Synthron/Nixie/README.md

# Nixie

A Nixie Clock with Z5600M and ESP32
