Synthron/Nixie/Hardware/dots_spacer.FCStd

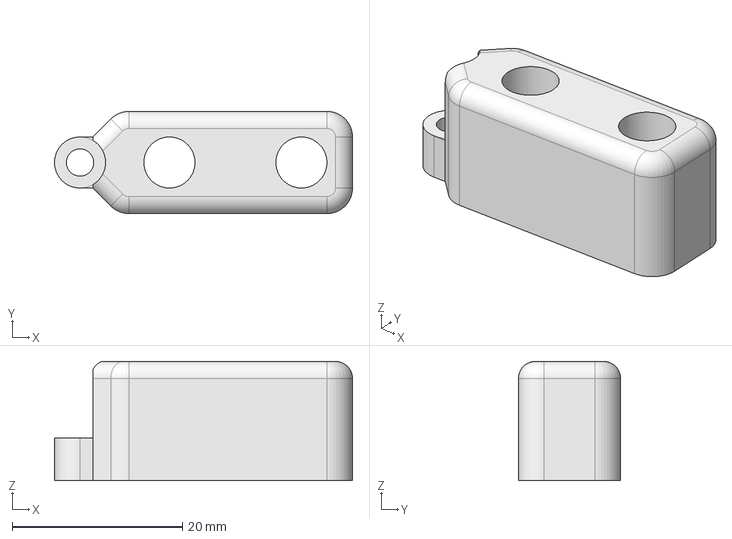
[picture p1: CAD file, 2024-10-21]
Hardware/dots_spacer.FCStd
35.0 x 12.0 x 14.0 mm
