Synthron/Nixie/Hardware/PCB/3d/NE-2 - Neon.STEP

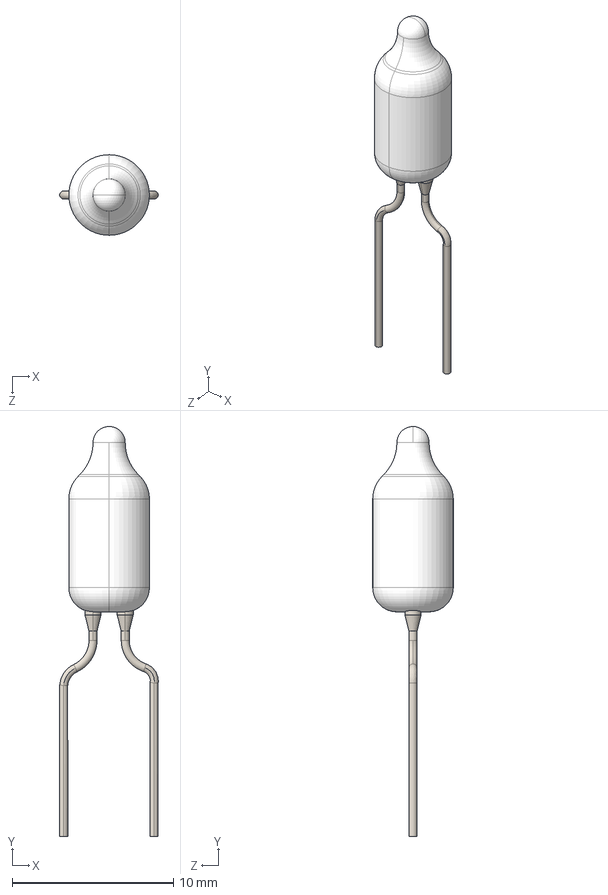
[picture p2: CAD file, 2024-09-22]
Hardware/PCB/3d/NE-2 - Neon.STEP
6.12 x 25.4 x 5.00 mm
