Synthron/Nixie/Hardware/covers.FCStd

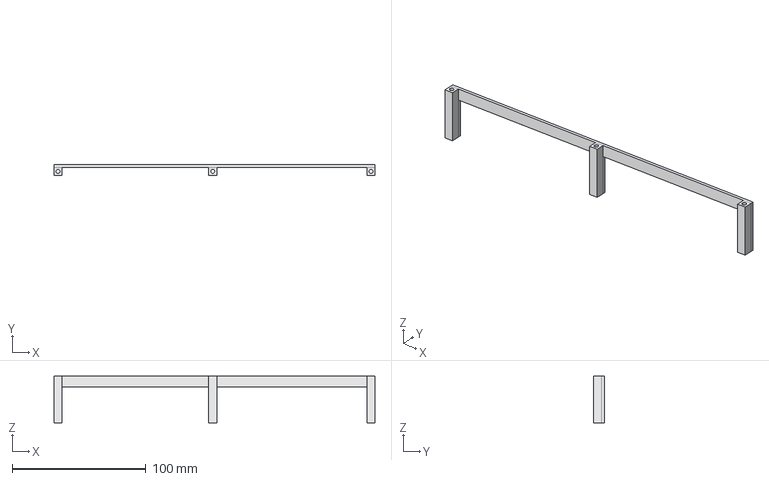
[picture p3: CAD file, 2024-10-21]
Hardware/covers.FCStd
240.0 x 8.00 x 35.0 mm
