Synthron/Nixie/Hardware/PCB/3d/SMB-002.stp

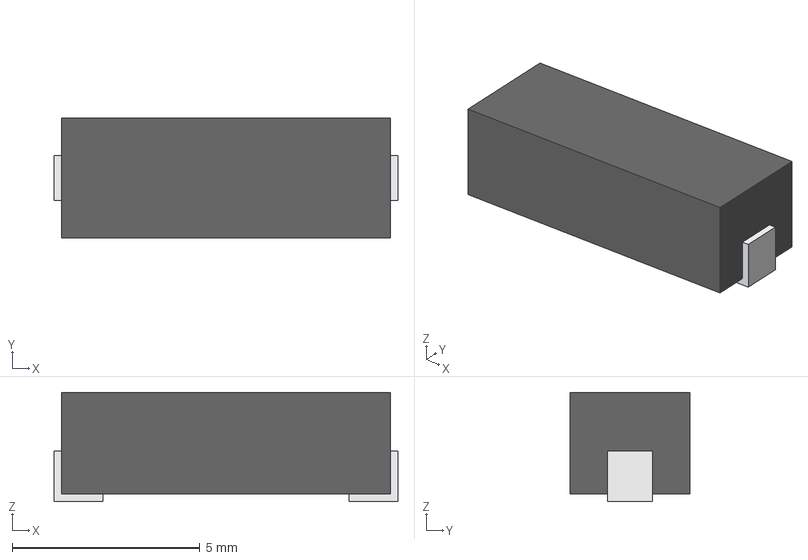
[picture p4: CAD file, 2024-09-22]
Hardware/PCB/3d/SMB-002.stp
9.15 x 3.20 x 2.90 mm
