Synthron/Nixie/Hardware/back_cover.3mf

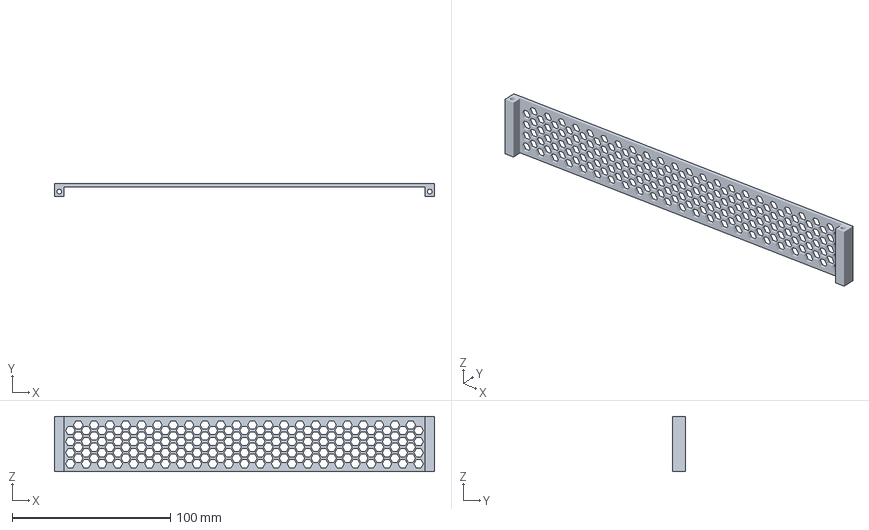
[picture p5: CAD file, 2024-10-20]
Hardware/back_cover.3mf
240.0 x 8.00 x 35.0 mm
