Synthron/Nixie/Hardware/PCB/3d/USB-B-S-F-B-TH.stp

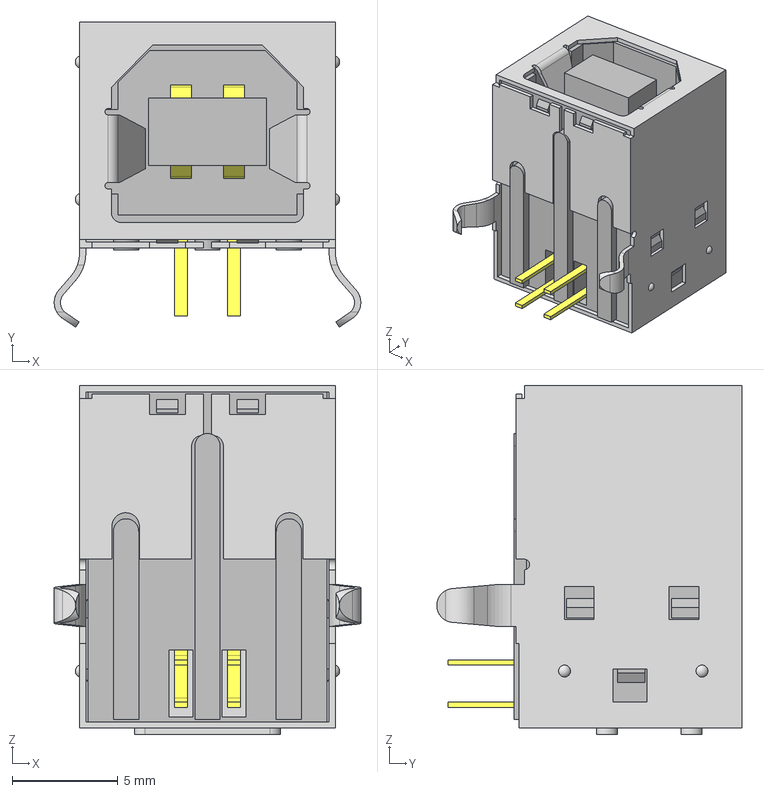
[picture p6: CAD file, 2024-09-22]
Hardware/PCB/3d/USB-B-S-F-B-TH.stp
14.5 x 14.4 x 16.5 mm
USB-B-S-TH_P
USB-B-S-B-TH_B
USB-B-S-TH_S
