Synthron/Nixie/Hardware/PCB/3d/SY317.step

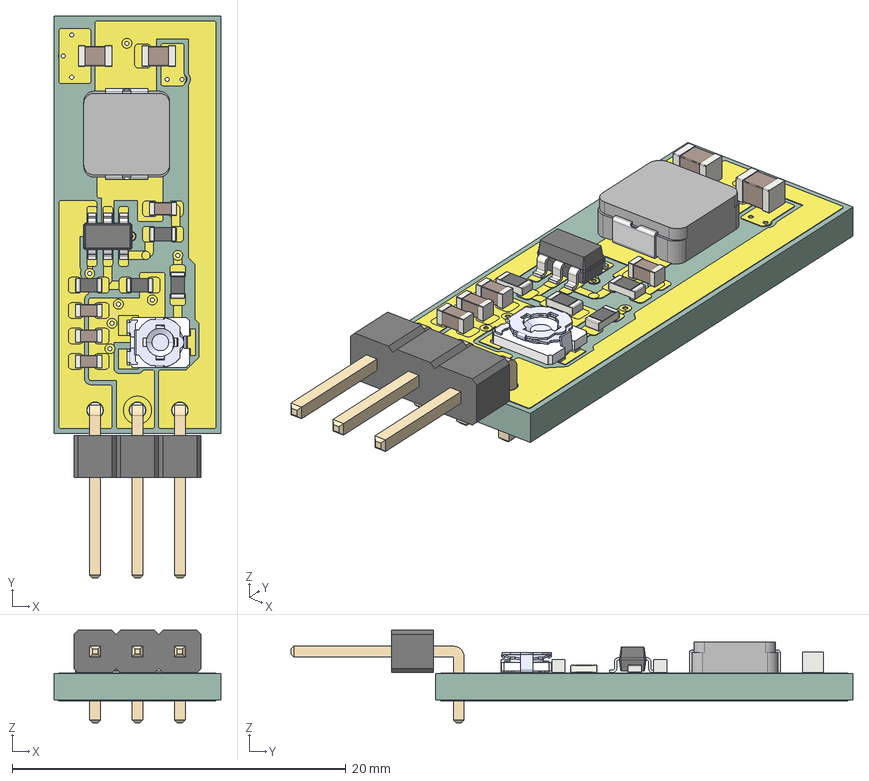
[picture p7: CAD file, 2024-09-18]
Hardware/PCB/3d/SY317.step
10.0 x 33.6 x 5.54 mm
C_0805_2012Metric x 2
R_0603_1608Metric x 4
C_0603_1608Metric x 4
IHLP2020BZ
TC33X-2-202E
PinHeader_1x03_P254mm_Horizontal
SOT_23_6
SY317_track_1
SY317_track_2
SY317_track_3
SY317_track_4
SY317_track_5
SY317_track_6
SY317_track_7
SY317_track_8
SY317_track_9
SY317_track_10
SY317_track_11
SY317_track_12
SY317_track_13
SY317_track_14
SY317_track_15
SY317_track_16
SY317_track_17
SY317_track_18
SY317_track_19
SY317_track_20
SY317_track_21
SY317_track_22
SY317_track_23
SY317_track_24
SY317_track_25
SY317_track_26
SY317_track_27
SY317_track_28
SY317_track_29
SY317_track_30
SY317_track_31
SY317_track_32
SY317_track_33
SY317_track_34
SY317_zone_1
SY317_zone_2
SY317_zone_3
SY317_zone_4
SY317_zone_5
SY317_zone_6
SY317_zone_7
SY317_pad_1
SY317_pad_2
SY317_pad_3
SY317_pad_4
SY317_pad_5
SY317_pad_6
SY317_pad_7
SY317_pad_8
SY317_pad_9
SY317_pad_10
SY317_pad_11
SY317_pad_12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
