Synthron/Nixie/Hardware/PCB/3d/h3161-01.stp

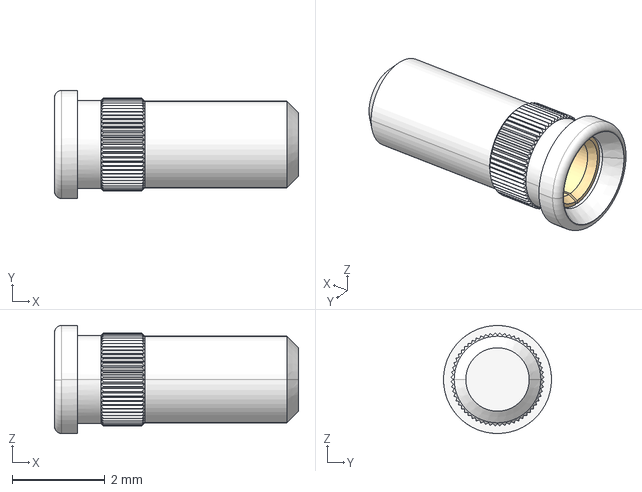
[picture p8: CAD file, 2024-09-16]
Hardware/PCB/3d/h3161-01.stp
5.25 x 2.33 x 2.33 mm
