Synthron/Nixie/(list of files, cad)

Other CAD files:
Hardware/front_cover.3mf
Hardware/dots_spacer.3mf
