Synthron/Nixie/Hardware/PCB/nixie.pdf

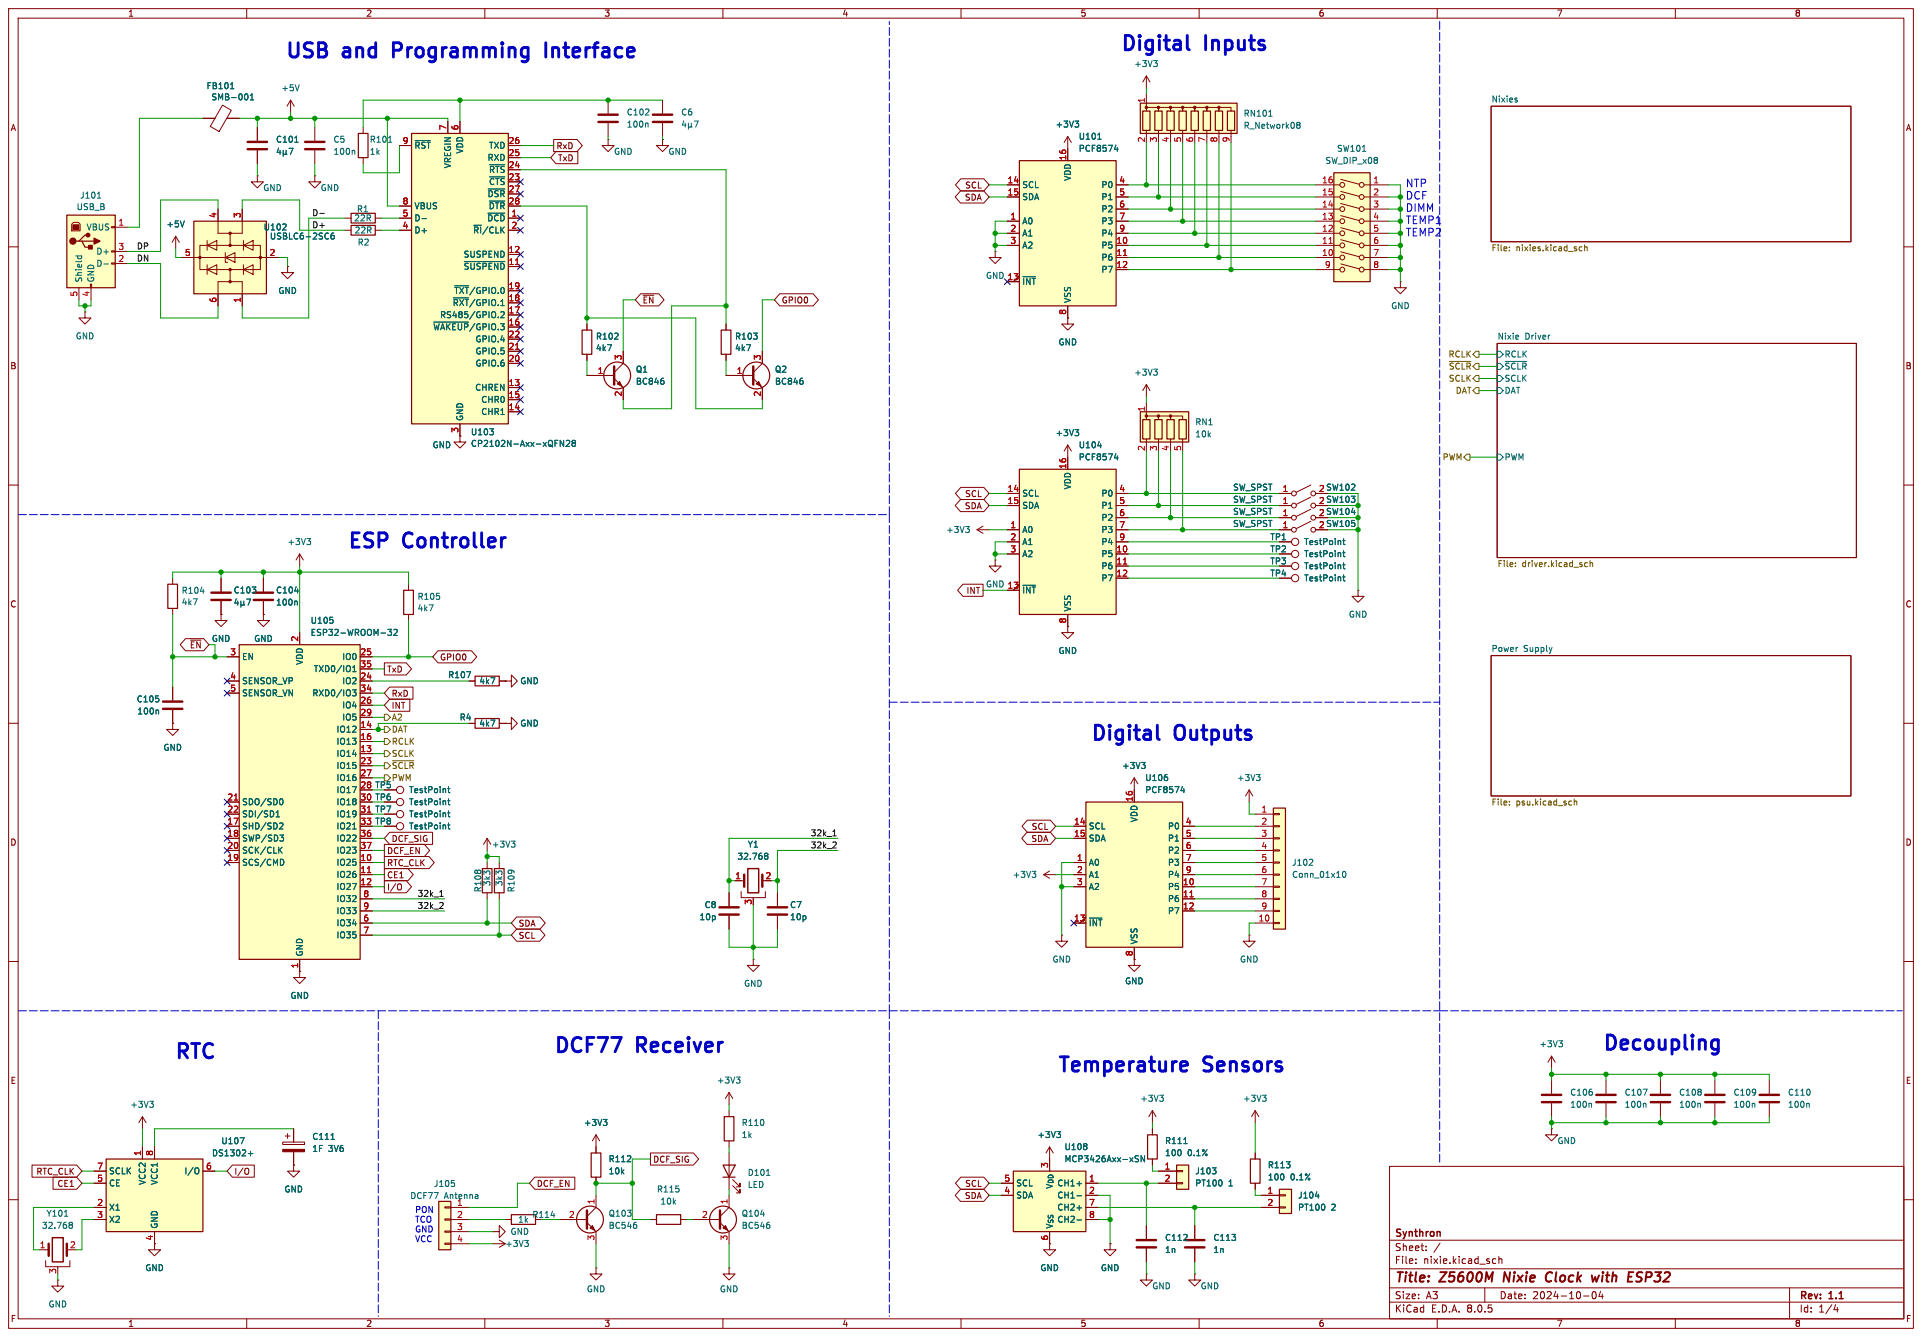
[picture p9: page 1]

Nixies File: nixies.kicad_sch RCLK

7 VBUS 8 ~{RST} 9 U103 GND CP2102N-Axx-xQFN28 +3V3 GND

7 VBUS 8 ~{RST} 9 GND GND

~{SCLR} SCLK DAT PWM

2 SCK/CLK 20 SDO/SD0 21 SDI/SD1 22

File: nixie.kicad_sch Sheet: / Synthron

Id: 1/4 Title: Z5600M Nixie Clock with ESP32

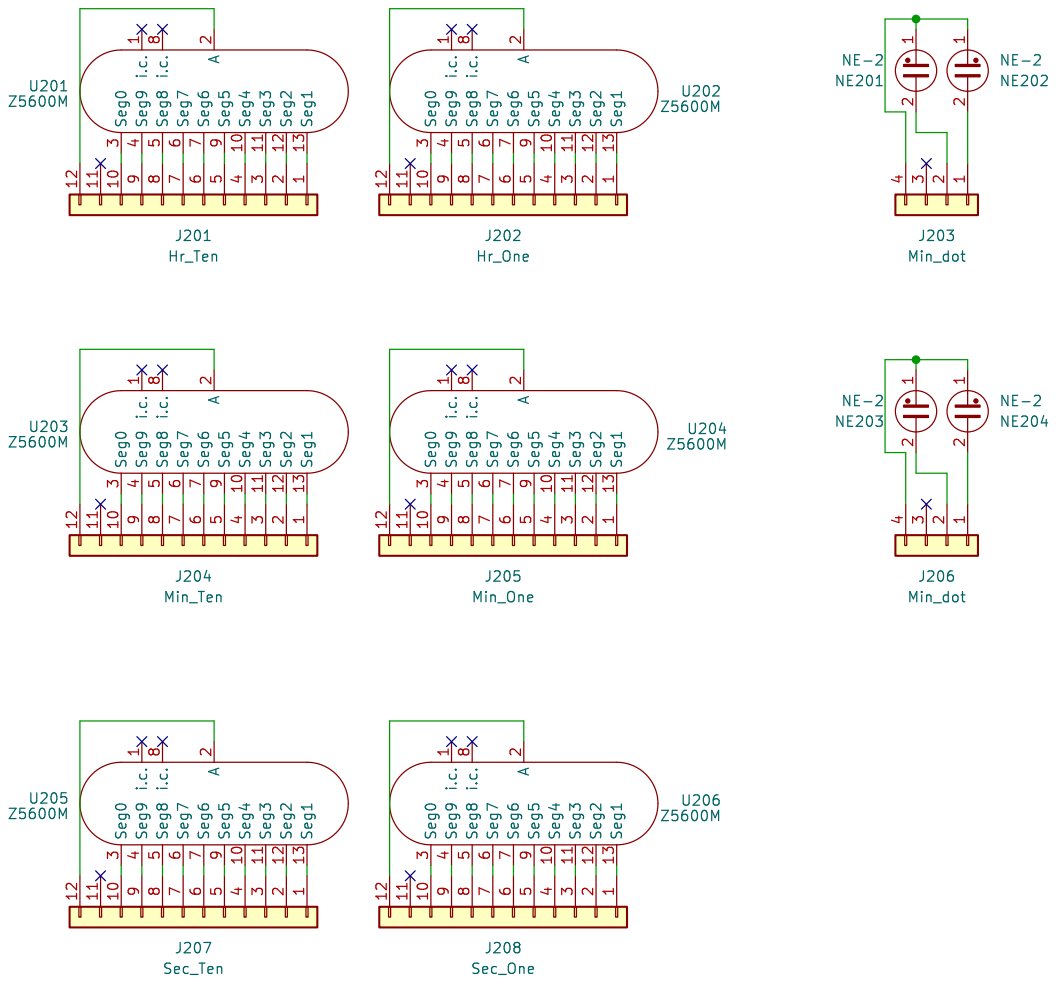
[picture p10: page 2]

Id: 2/4 Title: Z5600M Nixie Clock with ESP32

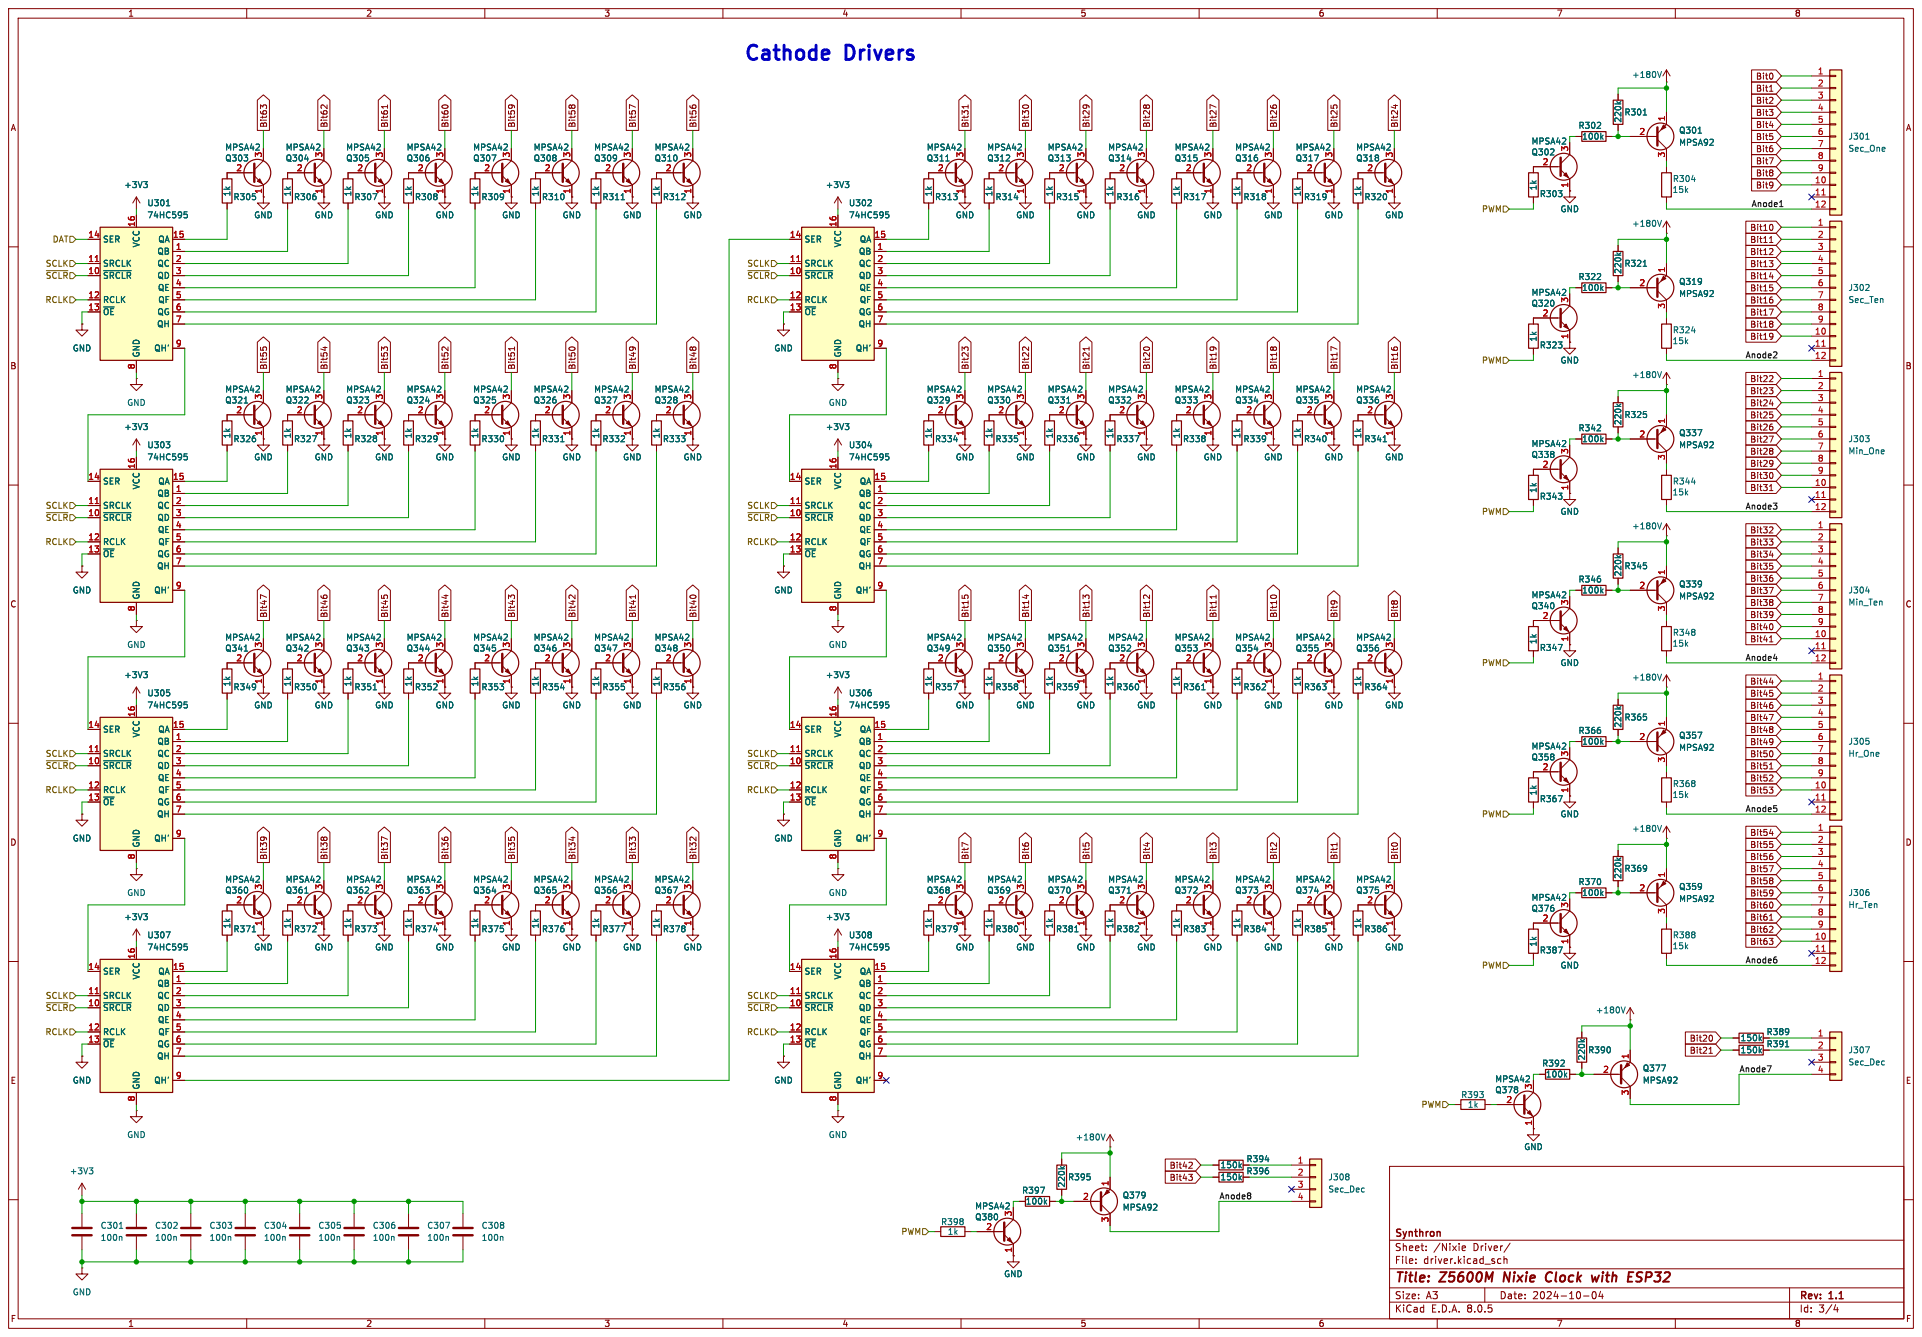
[picture p11: page 3]

3Q345 MPSA42GND GND QB 1 ~{SRCLR} 10 SRCLK 11 RCLK 12 ~{OE} 13 SER 14 QA 15 VCC 16 QC 2 QD 3 QE 4 QF 5 QG 6 QH 7 GND
DAT RCLK

3Q332 MPSA42 R337 1k R334 1k QB 1 ~{SRCLR} 10 SRCLK 11 RCLK 12 ~{OE} 13 SER 14 QA 15 VCC 16 QC 2 QD 3 QE 4 QF 5 QG 6 QH 7 GND

3Q330 MPSA42 GND QB 1 ~{SRCLR} 10 SRCLK 11 RCLK 12 ~{OE} 13 SER 14 QA 15 VCC 16 QC 2 QD 3 QE 4 QF 5 QG 6 QH 7 GND

3Q369 MPSA42 R380 1k QB 1 ~{SRCLR} 10 SRCLK 11 RCLK 12 ~{OE} 13 SER 14 QA 15 VCC 16 QC 2 QD 3 QE 4 QF 5 QG 6 QH 7 GND

3Q380 MPSA42 R395 220k QB 1 ~{SRCLR} 10 SRCLK 11 RCLK 12 ~{OE} 13 SER 14 QA 15 VCC 16 QC 2 QD 3 QE 4 QF 5 QG 6 QH 7 GND

Id: 3/4 Title: Z5600M Nixie Clock with ESP32

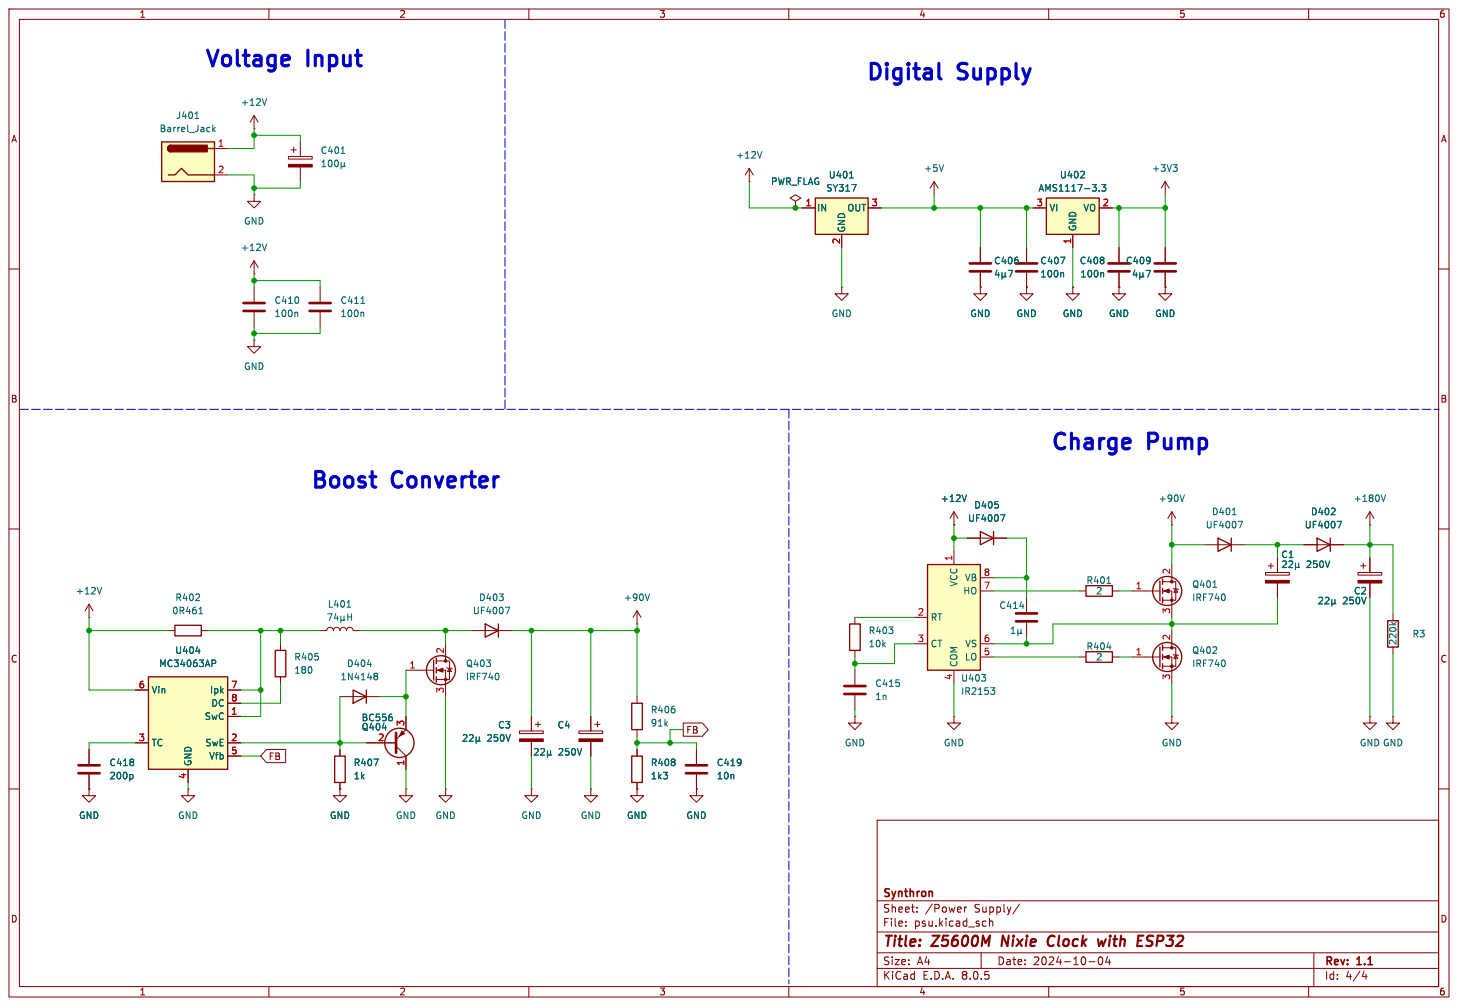
[picture p12: page 4]

Digital Supply Voltage Input

Id: 4/4 Title: Z5600M Nixie Clock with ESP32
