Synthron/Nixie/Hardware/PCB/nixies.kicad_pcb

## KiCad design Hardware/PCB/nixies.kicad_pcb (2024-10-05)

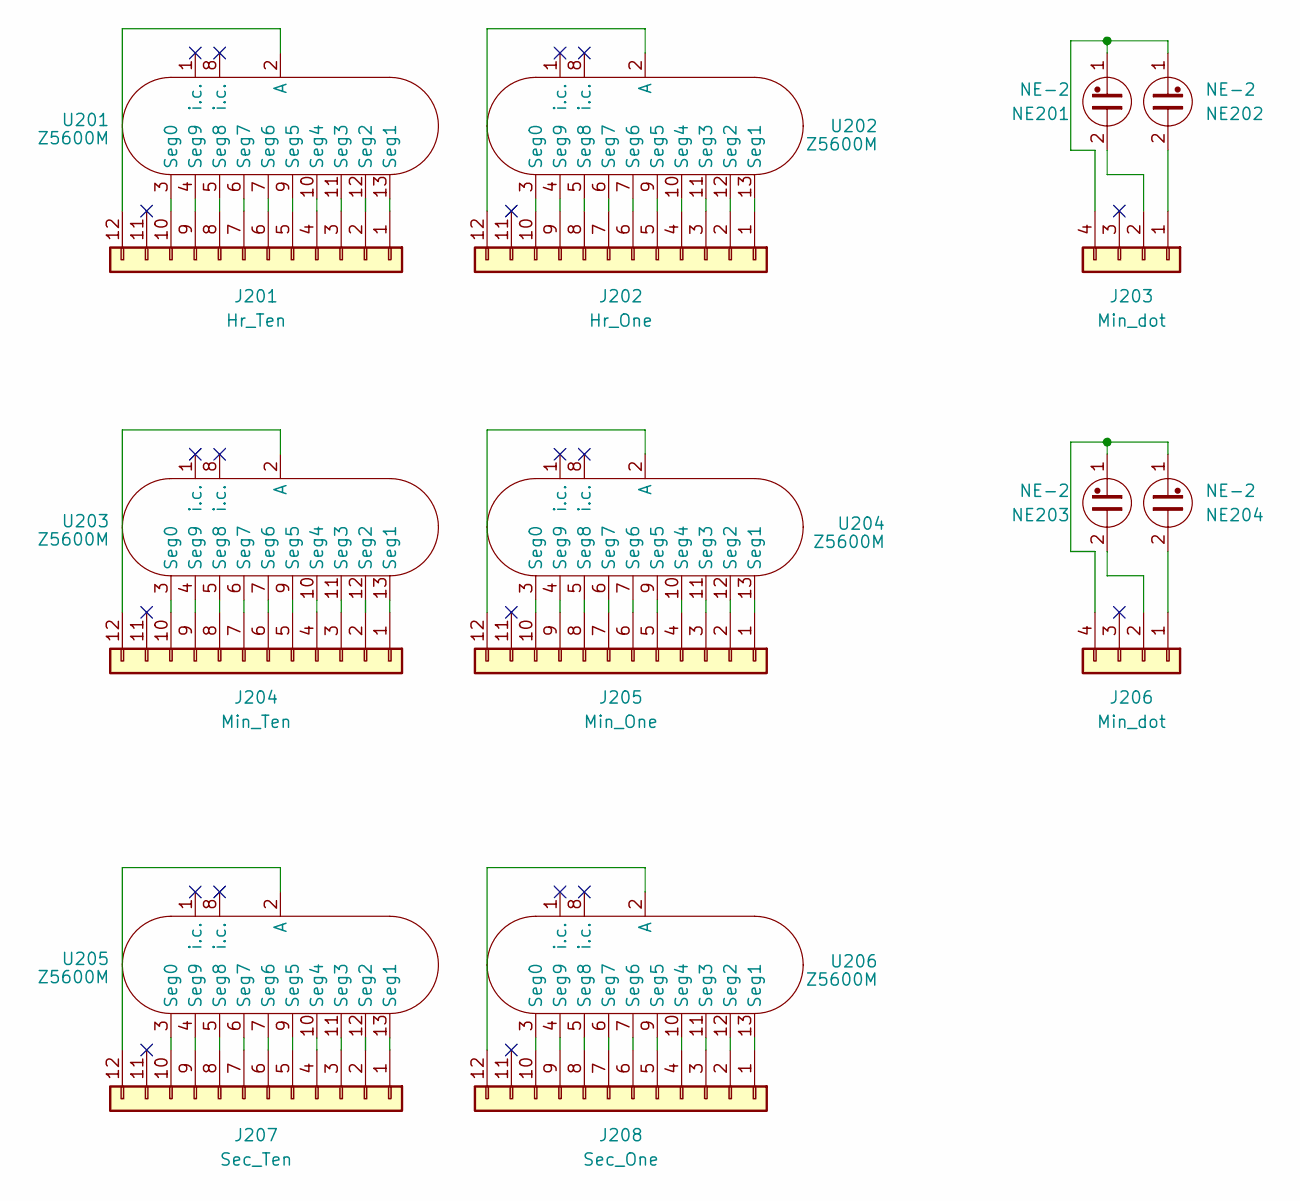
[picture p13: schematic nixies.kicad_sch, Z5600M Nixie Clock with ESP32]

Parts:
J201: Hr_Ten; PinSocket_1x12_P2.54mm_Vertical
J202: Hr_One; PinSocket_1x12_P2.54mm_Vertical
J203, J206: Min_dot; PinSocket_1x04_P2.54mm_Vertical
J204: Min_Ten; PinSocket_1x12_P2.54mm_Vertical
J205: Min_One; PinSocket_1x12_P2.54mm_Vertical
J207: Sec_Ten; PinSocket_1x12_P2.54mm_Vertical
J208: Sec_One; PinSocket_1x12_P2.54mm_Vertical
NE201, NE202, NE203, NE204: NE-2; Valve_Glimm
U201, U202, U203, U204, U205, U206: Z5600M; B13B

Connections:
unnamed: J201.1, U201.13 (Seg1)
unnamed: J201.2, U201.12 (Seg2)
unnamed: J201.3, U201.11 (Seg3)
unnamed: J201.4, U201.10 (Seg4)
unnamed: J201.5, U201.9 (Seg5)
unnamed: J201.6, U201.7 (Seg6)
unnamed: J201.7, U201.6 (Seg7)
unnamed: J201.8, U201.5 (Seg8)
unnamed: J201.9, U201.4 (Seg9)
unnamed: J201.10, U201.3 (Seg0)
unnamed: J201.12, U201.2 (A)
unnamed: J202.1, U202.13 (Seg1)
unnamed: J202.2, U202.12 (Seg2)
unnamed: J202.3, U202.11 (Seg3)
unnamed: J202.4, U202.10 (Seg4)
unnamed: J202.5, U202.9 (Seg5)
unnamed: J202.6, U202.7 (Seg6)
unnamed: J202.7, U202.6 (Seg7)
unnamed: J202.8, U202.5 (Seg8)
unnamed: J202.9, U202.4 (Seg9)
unnamed: J202.10, U202.3 (Seg0)
unnamed: J202.12, U202.2 (A)
unnamed: J203.1, NE202.2
unnamed: J203.2, NE201.2
unnamed: J203.4, NE201.1, NE202.1
unnamed: J204.1, U203.13 (Seg1)
unnamed: J204.2, U203.12 (Seg2)
unnamed: J204.3, U203.11 (Seg3)
unnamed: J204.4, U203.10 (Seg4)
unnamed: J204.5, U203.9 (Seg5)
unnamed: J204.6, U203.7 (Seg6)
unnamed: J204.7, U203.6 (Seg7)
unnamed: J204.8, U203.5 (Seg8)
unnamed: J204.9, U203.4 (Seg9)
unnamed: J204.10, U203.3 (Seg0)
unnamed: J204.12, U203.2 (A)
unnamed: J205.1, U204.13 (Seg1)
unnamed: J205.2, U204.12 (Seg2)
unnamed: J205.3, U204.11 (Seg3)
unnamed: J205.4, U204.10 (Seg4)
unnamed: J205.5, U204.9 (Seg5)
unnamed: J205.6, U204.7 (Seg6)
unnamed: J205.7, U204.6 (Seg7)
unnamed: J205.8, U204.5 (Seg8)
unnamed: J205.9, U204.4 (Seg9)
unnamed: J205.10, U204.3 (Seg0)
unnamed: J205.12, U204.2 (A)
unnamed: J206.1, NE204.2
unnamed: J206.2, NE203.2
unnamed: J206.4, NE203.1, NE204.1
unnamed: J207.1, U205.13 (Seg1)
unnamed: J207.2, U205.12 (Seg2)
unnamed: J207.3, U205.11 (Seg3)
unnamed: J207.4, U205.10 (Seg4)
unnamed: J207.5, U205.9 (Seg5)
unnamed: J207.6, U205.7 (Seg6)
unnamed: J207.7, U205.6 (Seg7)
unnamed: J207.8, U205.5 (Seg8)
unnamed: J207.9, U205.4 (Seg9)
unnamed: J207.10, U205.3 (Seg0)
unnamed: J207.12, U205.2 (A)
unnamed: J208.1, U206.13 (Seg1)
unnamed: J208.2, U206.12 (Seg2)
unnamed: J208.3, U206.11 (Seg3)
unnamed: J208.4, U206.10 (Seg4)
unnamed: J208.5, U206.9 (Seg5)
unnamed: J208.6, U206.7 (Seg6)
unnamed: J208.7, U206.6 (Seg7)
unnamed: J208.8, U206.5 (Seg8)
unnamed: J208.9, U206.4 (Seg9)
unnamed: J208.10, U206.3 (Seg0)
unnamed: J208.12, U206.2 (A)

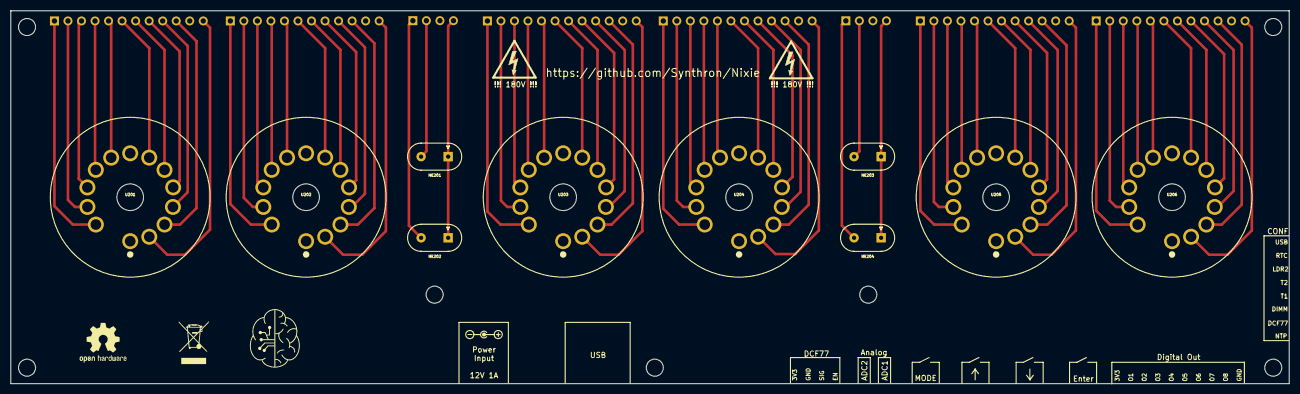
[picture p14: board nixies.kicad_pcb from above]

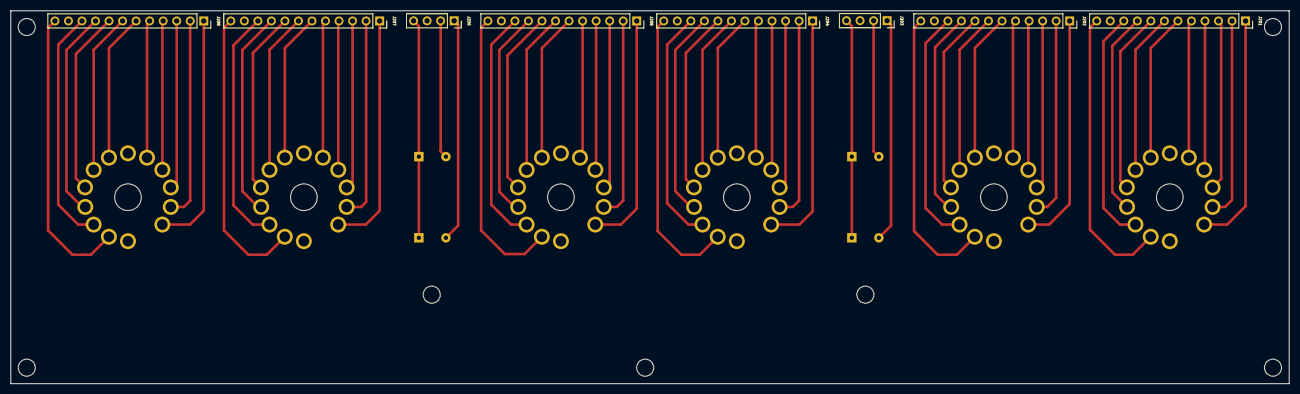
[picture p15: board nixies.kicad_pcb from below]

Board: 2 copper layers, 240.0 x 70.0 mm, 18 parts (8 on the bottom side), 72 nets.
