Synthron/Nixie/Hardware/PCB/nixie.kicad_pcb

## KiCad design Hardware/PCB/nixie.kicad_pcb (2024-09-29)

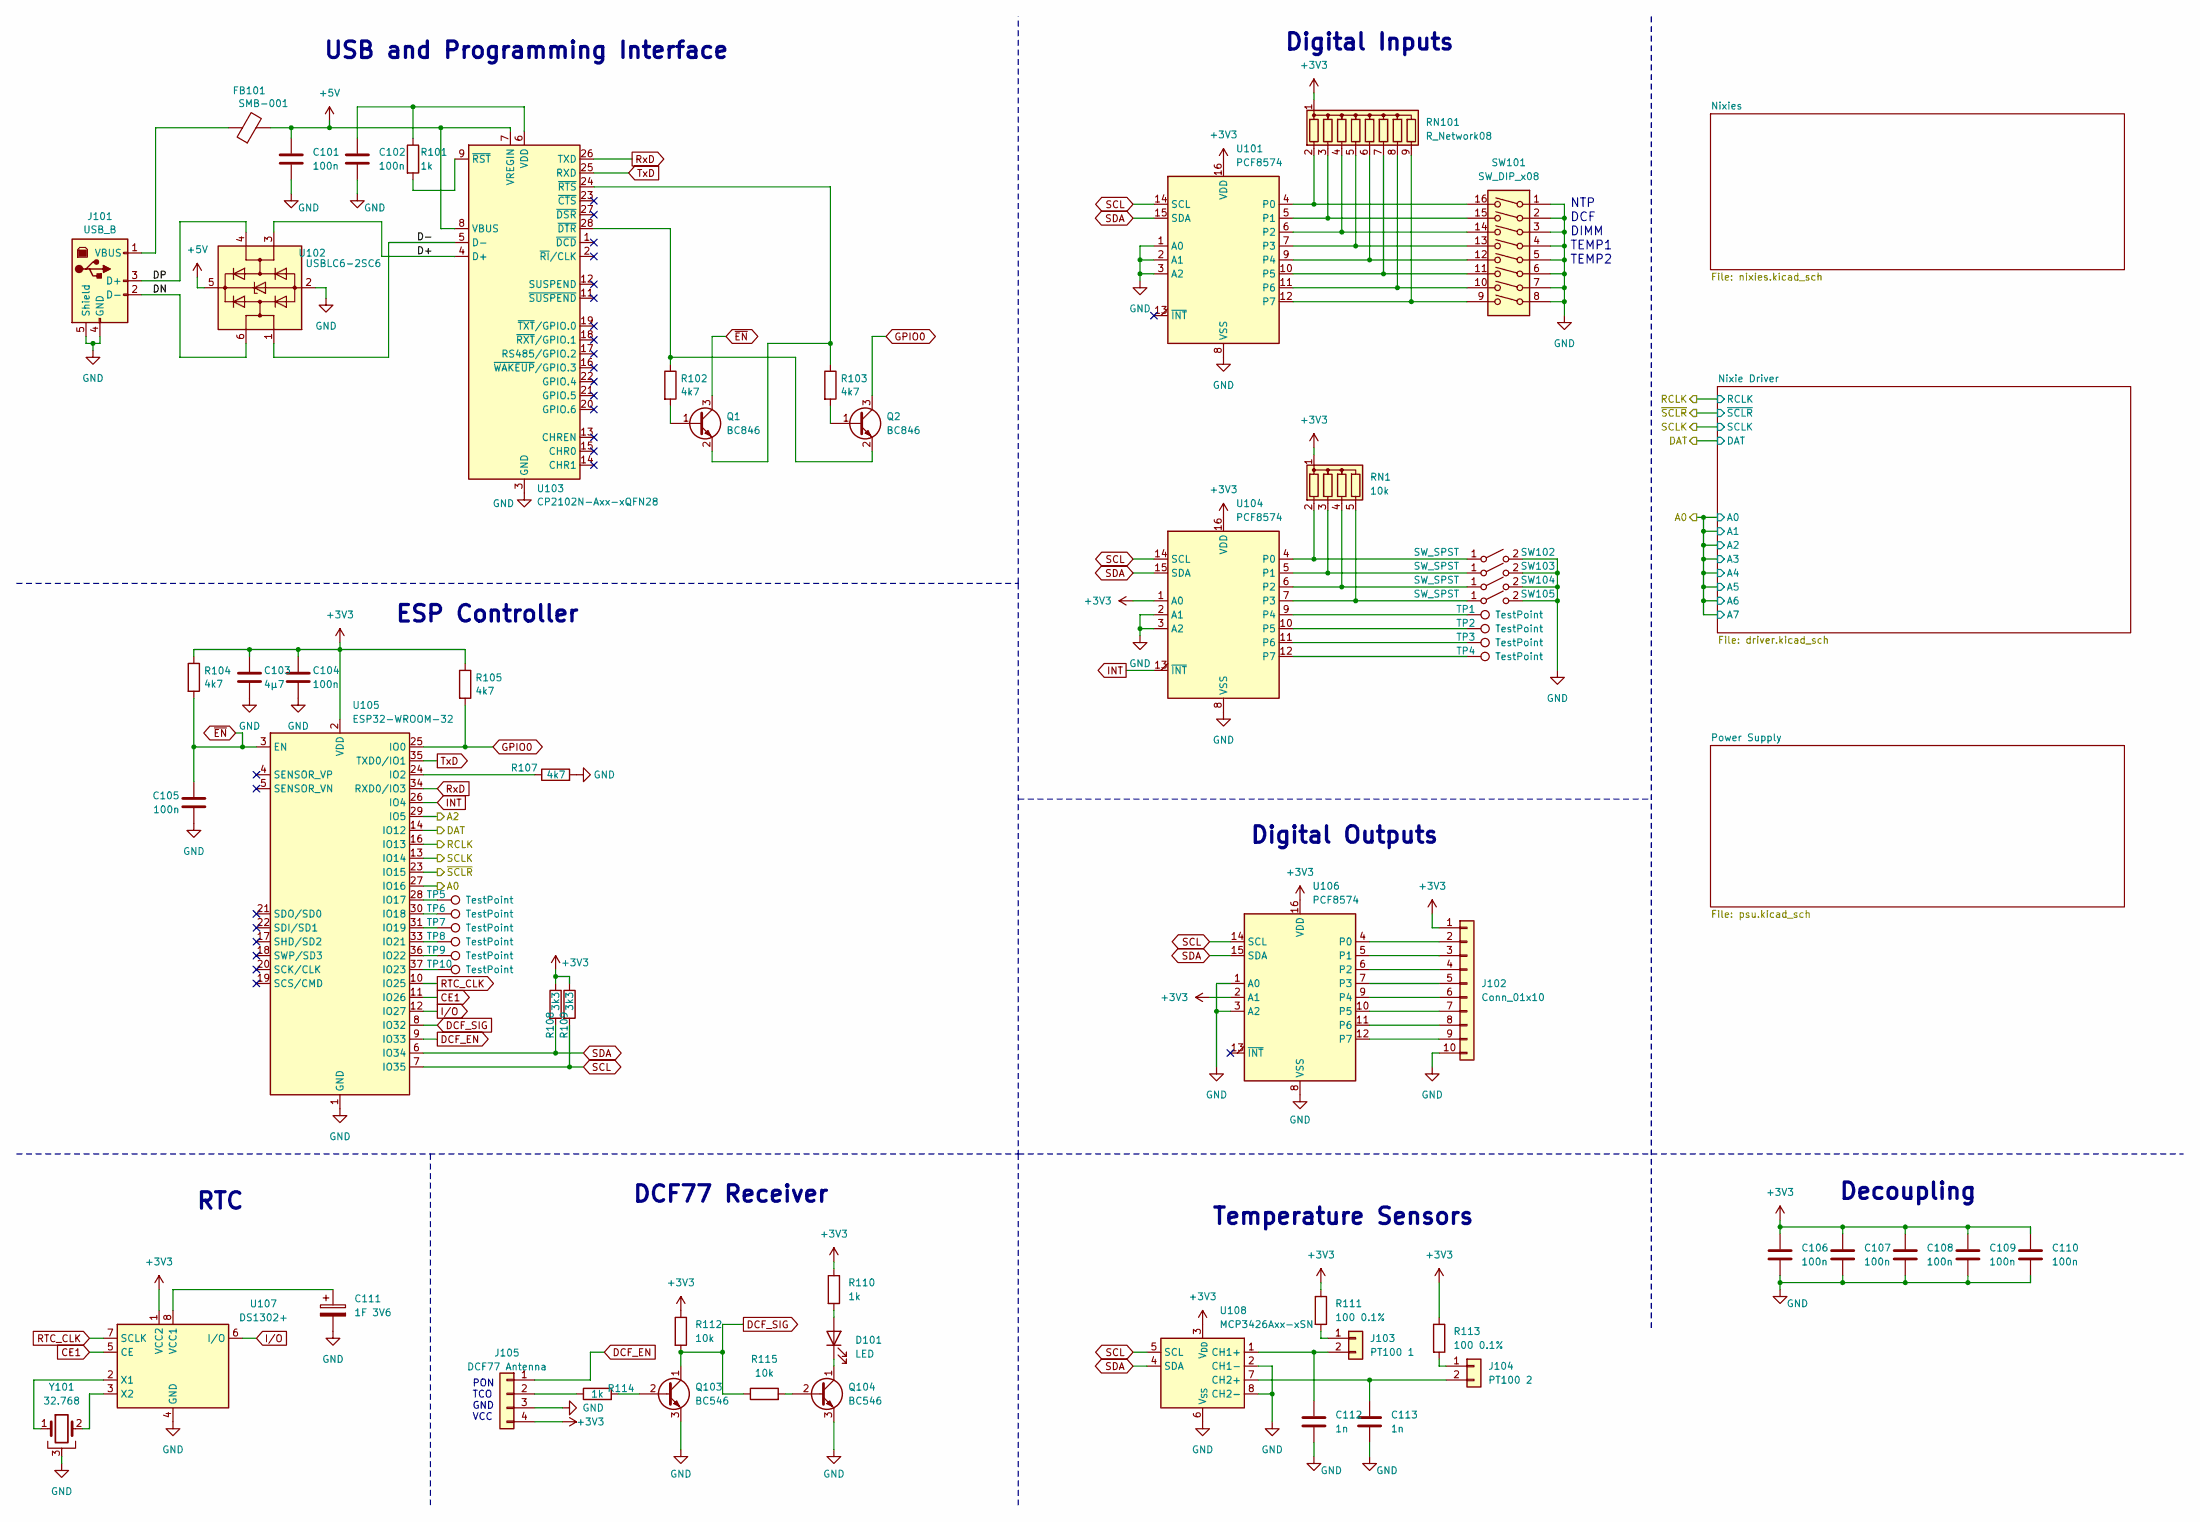
[picture p16: schematic nixie.kicad_sch, Z5600M Nixie Clock with ESP32]

Parts:
C101, C102, C104, C105: 100n; C_0805_2012Metric
C103: 4µ7; C_0805_2012Metric
C106, C107, C108, C109, C110: 100n; C_Disc_D3.0mm_W1.6mm_P2.50mm
C111: 1F 3V6; CP_Radial_D21.5mm_P5.00mm
C112, C113: 1n; C_Disc_D3.0mm_W1.6mm_P2.50mm
D101: LED; LED_D3.0mm
FB101: SMB-001; SMB-002
J101: USB_B; USB_B_Lumberg_2411_02_Horizontal
J102: Conn_01x10; PinHeader_1x10_P2.54mm_Vertical
J103: PT100 1; PinHeader_1x02_P2.54mm_Vertical
J104: PT100 2; PinHeader_1x02_P2.54mm_Vertical
J105: DCF77 Antenna; PinHeader_1x04_P2.54mm_Vertical
Q1, Q2: BC846; SOT-23
Q103, Q104: BC546; TO-92
R101: 1k; R_0805_2012Metric
R102, R103, R104, R105, R107: 4k7; R_0805_2012Metric
R108, R109: 3k3; R_0805_2012Metric
R110, R114: 1k; R_Axial_DIN0207_L6.3mm_D2.5mm_P2.54mm_Vertical
R111, R113: 100 0.1%; R_Axial_DIN0207_L6.3mm_D2.5mm_P2.54mm_Vertical
R112, R115: 10k; R_Axial_DIN0207_L6.3mm_D2.5mm_P2.54mm_Vertical
RN1: 10k; R_Array_SIP5
RN101: R_Network08; R_Array_SIP9
SW101: SW_DIP_x08; SW_DIP_SPSTx08_Piano_CTS_Series194-8MSTN_W7.62mm_P2.54mm
SW102, SW103, SW104, SW105: SW_SPST; SW_SPST_Omron_B3F-315x_Angled
TP1, TP2, TP3, TP4, TP5, TP6, TP7, TP8, TP9, TP10: TestPoint; Pin_D1.0mm_L10.0mm
U101, U104, U106: PCF8574; DIP-16_W7.62mm
U102: USBLC6-2SC6; SOT-23-6
U103: CP2102N-Axx-xQFN28; QFN-28-1EP_5x5mm_P0.5mm_EP3.35x3.35mm_ThermalVias
U105: ESP32-WROOM-32
U107: DS1302+; DIP-8_W7.62mm
U108: MCP3426Axx-xSN; SOIC-8_3.9x4.9mm_P1.27mm
Y101: 32.768; Crystal_SMD_MicroCrystal_MS1V-T1K

Connections:
+3V3: C103.1, C104.1, C106.1, C107.1, C108.1, C109.1, C110.1, J102.1, J105.4, R104.1, R105.1, R108.1, R109.1, R110.1, R111.1, R112.1, R113.1, RN1.1 (common), RN101.1 (common), U101.16 (VDD), U104.1 (A0), U104.16 (VDD), U105.2 (VDD), U106.2 (A1), U106.16 (VDD), U107.1 (VCC2), U108.3 (V_{DD}); also elsewhere on the board
+5V: C101.1, FB101.2, U102.5 (VBUS), U103.7 (VREGIN), U103.8 (VBUS); also elsewhere on the board
/A0: U105.27 (IO16); also elsewhere on the board
/A2: U105.29 (IO5)
/D+: U102.3 (I/O2), U103.4 (D+)
/D-: U102.1 (I/O1), U103.5 (D-)
/DAT: U105.14 (IO12); also elsewhere on the board
/DN: J101.2 (D-), U102.6 (I/O1)
/DP: J101.3 (D+), U102.4 (I/O2)
/RCLK: U105.16 (IO13); also elsewhere on the board
/SCLK: U105.13 (IO14); also elsewhere on the board
/~SCLR: U105.23 (IO15); also elsewhere on the board
CE1: U105.11 (IO26), U107.5 (CE)
DCF_EN: J105.1, U105.9 (IO33)
DCF_SIG: Q103.1 (C), R112.2, R115.1, U105.8 (IO32)
GND: C101.2, C102.2, C103.2, C104.2, C105.2, C106.2, C107.2, C108.2, C109.2, C110.2, C111.2, C112.2, C113.2, J101.4 (GND), J101.5 (Shield), J102.10, J105.3, Q103.3 (E), Q104.3 (E), R107.2, SW101.1, SW101.2, SW101.3, SW101.4, SW101.5, SW101.6, SW101.7, SW101.8, SW102.2 (B), SW103.2 (B), SW104.2 (B), SW105.2 (B), U101.1 (A0), U101.2 (A1), U101.3 (A2), U101.8 (VSS), U102.2 (GND), U103.3 (GND), U103.29 (GND), U104.2 (A1), U104.3 (A2), U104.8 (VSS), U105.1 (GND), U105.15 (GND), U105.38 (GND), U105.39 (GND), U106.1 (A0), U106.3 (A2), U106.8 (VSS), U107.4 (GND), U108.2 (CH1-), U108.6 (V_{SS}), U108.8 (CH2-), Y101.3; also elsewhere on the board
GPIO0: Q2.3 (C), R105.2, U105.25 (IO0)
INT: U104.13 (~INT), U105.26 (IO4)
I/O: U105.12 (IO27), U107.6 (I/O)
unnamed: D101.2 (A), R110.2
unnamed: D101.1 (K), Q104.1 (C)
unnamed: FB101.1, J101.1 (VBUS)
unnamed: J102.2, U106.4 (P0)
unnamed: J102.3, U106.5 (P1)
unnamed: J102.4, U106.6 (P2)
unnamed: J102.5, U106.7 (P3)
unnamed: J102.6, U106.9 (P4)
unnamed: J102.7, U106.10 (P5)
unnamed: J102.8, U106.11 (P6)
unnamed: J102.9, U106.12 (P7)
unnamed: J103.1, R111.2
unnamed: C112.1, J103.2, U108.1 (CH1+)
unnamed: J104.1, R113.2
unnamed: C113.1, J104.2, U108.7 (CH2+)
unnamed: J105.2, R114.1
unnamed: Q1.1 (B), R102.2
unnamed: Q1.2 (E), R103.1, U103.24 (~RTS)
unnamed: Q2.1 (B), R103.2
unnamed: Q2.2 (E), R102.1, U103.28 (~DTR)
unnamed: Q103.2 (B), R114.2
unnamed: Q104.2 (B), R115.2
unnamed: RN1.2 (R1), SW102.1 (A), U104.4 (P0)
unnamed: RN1.3 (R2), SW103.1 (A), U104.5 (P1)
unnamed: RN1.4 (R3), SW104.1 (A), U104.6 (P2)
unnamed: RN1.5 (R4), SW105.1 (A), U104.7 (P3)
unnamed: RN101.2 (R1), SW101.16, U101.4 (P0)
unnamed: RN101.3 (R2), SW101.15, U101.5 (P1)
unnamed: RN101.4 (R3), SW101.14, U101.6 (P2)
unnamed: RN101.5 (R4), SW101.13, U101.7 (P3)
unnamed: RN101.6 (R5), SW101.12, U101.9 (P4)
unnamed: RN101.7 (R6), SW101.11, U101.10 (P5)
unnamed: RN101.8 (R7), SW101.10, U101.11 (P6)
unnamed: RN101.9 (R8), SW101.9, U101.12 (P7)
unnamed: C102.1, R101.1, U103.6 (VDD)
unnamed: R101.2, U103.9 (~RST)
unnamed: TP1.1, U104.9 (P4)
unnamed: TP2.1, U104.10 (P5)
unnamed: TP3.1, U104.11 (P6)
unnamed: TP4.1, U104.12 (P7)
unnamed: R107.1, U105.24 (IO2)
unnamed: TP5.1, U105.28 (IO17)
unnamed: TP6.1, U105.30 (IO18)
unnamed: TP7.1, U105.31 (IO19)
unnamed: TP8.1, U105.33 (IO21)
unnamed: TP9.1, U105.36 (IO22)
unnamed: TP10.1, U105.37 (IO23)
unnamed: C111.1, U107.8 (VCC1)
unnamed: U107.2 (X1), Y101.1
unnamed: U107.3 (X2), Y101.2
RTC_CLK: U105.10 (IO25), U107.7 (SCLK)
RxD: U103.26 (TXD), U105.34 (RXD0/IO3)
SCL: R109.2, U101.14 (SCL), U104.14 (SCL), U105.7 (IO35), U106.14 (SCL), U108.5 (SCL)
SDA: R108.2, U101.15 (SDA), U104.15 (SDA), U105.6 (IO34), U106.15 (SDA), U108.4 (SDA)
TxD: U103.25 (RXD), U105.35 (TXD0/IO1)
~EN: C105.1, Q1.3 (C), R104.2, U105.3 (EN)

Notes on the sheet:
NTP DCF DIMM TEMP1 TEMP2
USB and Programming Interface
Temperature Sensors
PON TCO GND VCC
DCF77 Receiver
Decoupling
ESP Controller
Digital Outputs
RTC
Digital Inputs

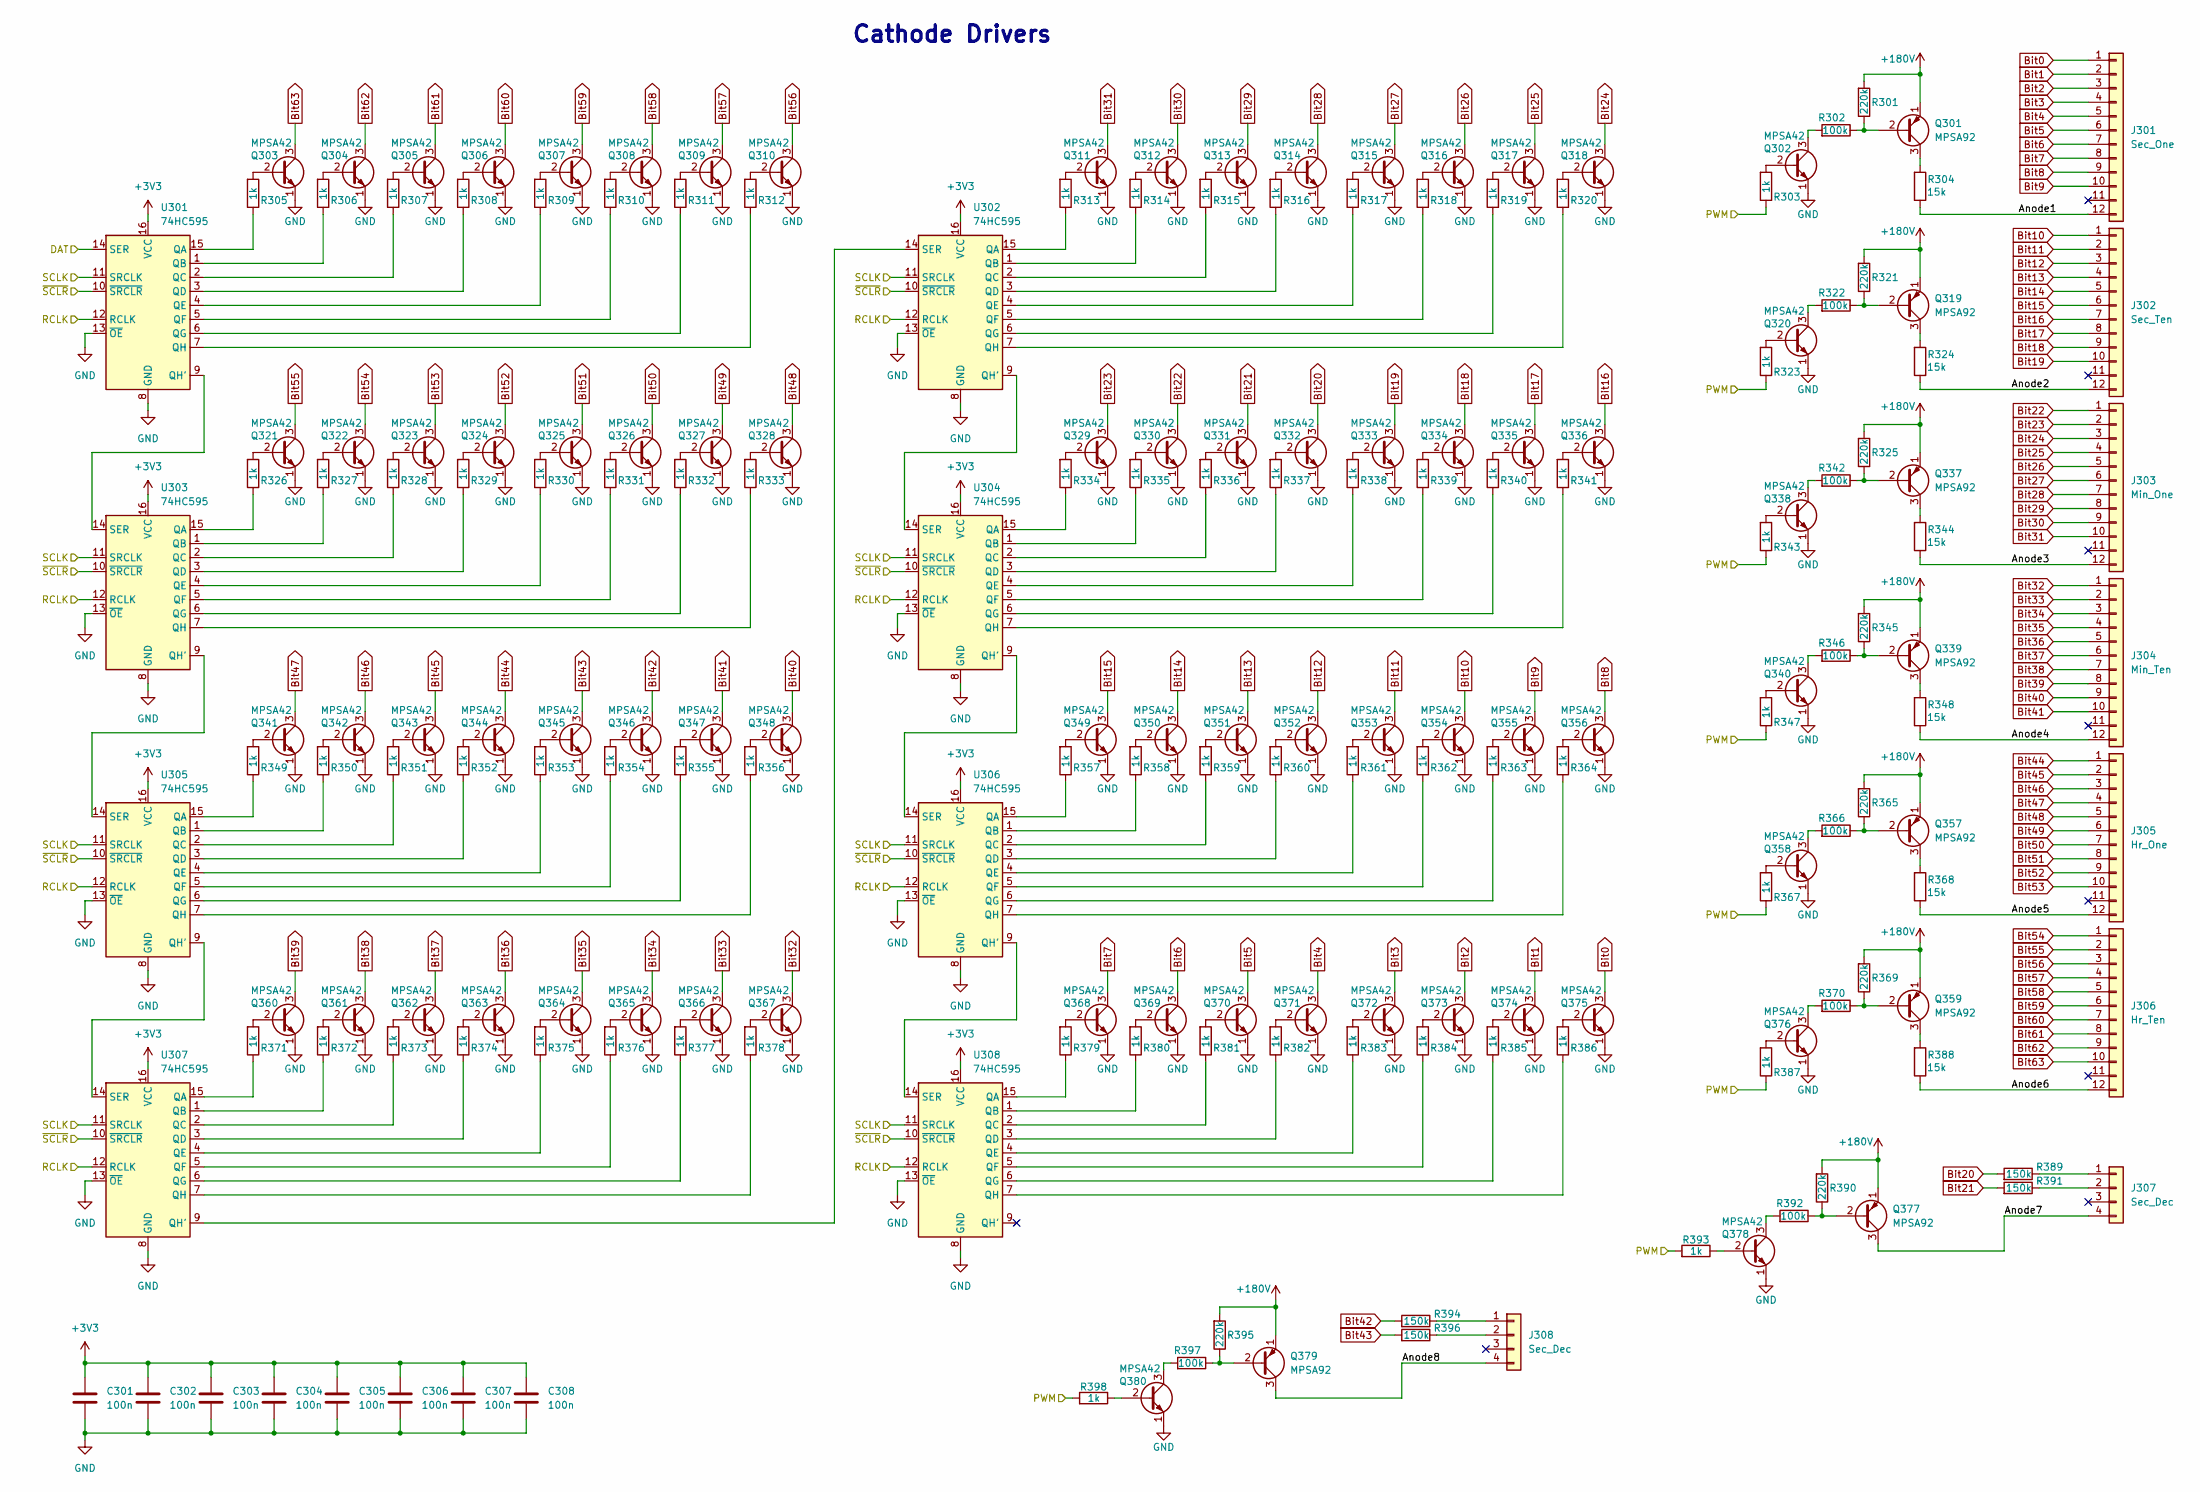
[picture p17: schematic driver.kicad_sch, Z5600M Nixie Clock with ESP32]

Parts:
C301, C302, C303, C304, C305, C306, C307, C308: 100n; C_Disc_D3.0mm_W1.6mm_P2.50mm
J301: Sec_One; PinHeader_1x12_P2.54mm_Vertical
J302: Sec_Ten; PinHeader_1x12_P2.54mm_Vertical
J303: Min_One; PinHeader_1x12_P2.54mm_Vertical
J304: Min_Ten; PinHeader_1x12_P2.54mm_Vertical
J305: Hr_One; PinHeader_1x12_P2.54mm_Vertical
J306: Hr_Ten; PinHeader_1x12_P2.54mm_Vertical
J307, J308: Sec_Dec; PinHeader_1x04_P2.54mm_Vertical
Q301, Q319, Q337, Q339, Q357, Q359, Q377, Q379: MPSA92; TO-92
Q302, Q303, Q304, Q305, Q306, Q307, Q308, Q309, Q310, Q311, Q312, Q313, Q314, Q315, Q316, Q317, Q318, Q320, Q321, Q322, Q323, Q324, Q325, Q326, Q327, Q328, Q329, Q330, Q331, Q332, Q333, Q334, Q335, Q336, Q338, Q340, Q341, Q342, Q343, Q344, Q345, Q346, Q347, Q348, Q349, Q350, Q351, Q352, Q353, Q354, Q355, Q356, Q358, Q360, Q361, Q362, Q363, Q364, Q365, Q366, Q367, Q368, Q369, Q370, Q371, Q372, Q373, Q374, Q375, Q376, Q378, Q380: MPSA42; TO-92
R301, R321, R325, R345, R365, R369, R390, R395: 220k; R_Axial_DIN0207_L6.3mm_D2.5mm_P2.54mm_Vertical
R302, R322, R342, R346, R366, R370, R392, R397: 100k; R_Axial_DIN0207_L6.3mm_D2.5mm_P2.54mm_Vertical
R303, R343, R367, R393: 1k; R_Axial_DIN0207_L6.3mm_D2.5mm_P7.62mm_Horizontal
R304, R324, R344, R348, R368, R388: 15k; R_Axial_DIN0207_L6.3mm_D2.5mm_P2.54mm_Vertical
R305, R306, R307, R308, R309, R310, R311, R312, R313, R314, R315, R316, R317, R318, R319, R320, R323, R326, R327, R328, R329, R330, R331, R332, R333, R334, R335, R336, R337, R338, R339, R340, R341, R347, R349, R350, R351, R352, R353, R354, R355, R356, R357, R358, R359, R360, R361, R362, R363, R364, R371, R372, R373, R374, R375, R376, R377, R378, R379, R380, R381, R382, R383, R384, R385, R386, R387, R398: 1k; R_Axial_DIN0207_L6.3mm_D2.5mm_P2.54mm_Vertical
R389, R391, R394, R396: 150k; R_Axial_DIN0207_L6.3mm_D2.5mm_P2.54mm_Vertical
U301, U302, U303, U304, U305, U306, U307, U308: 74HC595; DIP-16_W7.62mm

Connections:
+3V3: C301.1, C302.1, C303.1, C304.1, C305.1, C306.1, C307.1, C308.1, U301.16 (VCC), U302.16 (VCC), U303.16 (VCC), U304.16 (VCC), U305.16 (VCC), U306.16 (VCC), U307.16 (VCC), U308.16 (VCC); also elsewhere on the board
+180V: Q301.1 (E), Q319.1 (E), Q337.1 (E), Q339.1 (E), Q357.1 (E), Q359.1 (E), Q377.1 (E), Q379.1 (E), R301.2, R321.2, R325.2, R345.2, R365.2, R369.2, R390.2, R395.2; also elsewhere on the board
/A0: R303.1, R323.1, R343.1, R347.1, R367.1, R387.1, R393.2, R398.2; also elsewhere on the board
/DAT: U301.14 (SER); also elsewhere on the board
/Nixie Driver/Anode1: J301.12, R304.1
/Nixie Driver/Anode2: J302.12, R324.1
/Nixie Driver/Anode3: J303.12, R344.1
/Nixie Driver/Anode4: J304.12, R348.1
/Nixie Driver/Anode5: J305.12, R368.1
/Nixie Driver/Anode6: J306.12, R388.1
/Nixie Driver/Anode7: J307.4, Q377.3 (C)
/Nixie Driver/Anode8: J308.4, Q379.3 (C)
/RCLK: U301.12 (RCLK), U302.12 (RCLK), U303.12 (RCLK), U304.12 (RCLK), U305.12 (RCLK), U306.12 (RCLK), U307.12 (RCLK), U308.12 (RCLK); also elsewhere on the board
/SCLK: U301.11 (SRCLK), U302.11 (SRCLK), U303.11 (SRCLK), U304.11 (SRCLK), U305.11 (SRCLK), U306.11 (SRCLK), U307.11 (SRCLK), U308.11 (SRCLK); also elsewhere on the board
/~SCLR: U301.10 (~SRCLR), U302.10 (~SRCLR), U303.10 (~SRCLR), U304.10 (~SRCLR), U305.10 (~SRCLR), U306.10 (~SRCLR), U307.10 (~SRCLR), U308.10 (~SRCLR); also elsewhere on the board
Bit0: J301.1, Q375.3 (C)
Bit1: J301.2, Q374.3 (C)
Bit2: J301.3, Q373.3 (C)
Bit3: J301.4, Q372.3 (C)
Bit4: J301.5, Q371.3 (C)
Bit5: J301.6, Q370.3 (C)
Bit6: J301.7, Q369.3 (C)
Bit7: J301.8, Q368.3 (C)
Bit8: J301.9, Q356.3 (C)
Bit9: J301.10, Q355.3 (C)
Bit10: J302.1, Q354.3 (C)
Bit11: J302.2, Q353.3 (C)
Bit12: J302.3, Q352.3 (C)
Bit13: J302.4, Q351.3 (C)
Bit14: J302.5, Q350.3 (C)
Bit15: J302.6, Q349.3 (C)
Bit16: J302.7, Q336.3 (C)
Bit17: J302.8, Q335.3 (C)
Bit18: J302.9, Q334.3 (C)
Bit19: J302.10, Q333.3 (C)
Bit20: Q332.3 (C), R389.2
Bit21: Q331.3 (C), R391.2
Bit22: J303.1, Q330.3 (C)
Bit23: J303.2, Q329.3 (C)
Bit24: J303.3, Q318.3 (C)
Bit25: J303.4, Q317.3 (C)
Bit26: J303.5, Q316.3 (C)
Bit27: J303.6, Q315.3 (C)
Bit28: J303.7, Q314.3 (C)
Bit29: J303.8, Q313.3 (C)
Bit30: J303.9, Q312.3 (C)
Bit31: J303.10, Q311.3 (C)
Bit32: J304.1, Q367.3 (C)
Bit33: J304.2, Q366.3 (C)
Bit34: J304.3, Q365.3 (C)
Bit35: J304.4, Q364.3 (C)
Bit36: J304.5, Q363.3 (C)
Bit37: J304.6, Q362.3 (C)
Bit38: J304.7, Q361.3 (C)
Bit39: J304.8, Q360.3 (C)
Bit40: J304.9, Q348.3 (C)
Bit41: J304.10, Q347.3 (C)
Bit42: Q346.3 (C), R394.2
Bit43: Q345.3 (C), R396.2
Bit44: J305.1, Q344.3 (C)
Bit45: J305.2, Q343.3 (C)
Bit46: J305.3, Q342.3 (C)
Bit47: J305.4, Q341.3 (C)
Bit48: J305.5, Q328.3 (C)
Bit49: J305.6, Q327.3 (C)
Bit50: J305.7, Q326.3 (C)
Bit51: J305.8, Q325.3 (C)
Bit52: J305.9, Q324.3 (C)
Bit53: J305.10, Q323.3 (C)
Bit54: J306.1, Q322.3 (C)
Bit55: J306.2, Q321.3 (C)
Bit56: J306.3, Q310.3 (C)
Bit57: J306.4, Q309.3 (C)
Bit58: J306.5, Q308.3 (C)
Bit59: J306.6, Q307.3 (C)
Bit60: J306.7, Q306.3 (C)
Bit61: J306.8, Q305.3 (C)
Bit62: J306.9, Q304.3 (C)
Bit63: J306.10, Q303.3 (C)
GND: C301.2, C302.2, C303.2, C304.2, C305.2, C306.2, C307.2, C308.2, Q302.1 (E), Q303.1 (E), Q304.1 (E), Q305.1 (E), Q306.1 (E), Q307.1 (E), Q308.1 (E), Q309.1 (E), Q310.1 (E), Q311.1 (E), Q312.1 (E), Q313.1 (E), Q314.1 (E), Q315.1 (E), Q316.1 (E), Q317.1 (E), Q318.1 (E), Q320.1 (E), Q321.1 (E), Q322.1 (E), Q323.1 (E), Q324.1 (E), Q325.1 (E), Q326.1 (E), Q327.1 (E), Q328.1 (E), Q329.1 (E), Q330.1 (E), Q331.1 (E), Q332.1 (E), Q333.1 (E), Q334.1 (E), Q335.1 (E), Q336.1 (E), Q338.1 (E), Q340.1 (E), Q341.1 (E), Q342.1 (E), Q343.1 (E), Q344.1 (E), Q345.1 (E), Q346.1 (E), Q347.1 (E), Q348.1 (E), Q349.1 (E), Q350.1 (E), Q351.1 (E), Q352.1 (E), Q353.1 (E), Q354.1 (E), Q355.1 (E), Q356.1 (E), Q358.1 (E), Q360.1 (E), Q361.1 (E), Q362.1 (E), Q363.1 (E), Q364.1 (E), Q365.1 (E), Q366.1 (E), Q367.1 (E), Q368.1 (E), Q369.1 (E), Q370.1 (E), Q371.1 (E), Q372.1 (E), Q373.1 (E), Q374.1 (E), Q375.1 (E), Q376.1 (E), Q378.1 (E), Q380.1 (E), U301.8 (GND), U301.13 (~OE), U302.8 (GND), U302.13 (~OE), U303.8 (GND), U303.13 (~OE), U304.8 (GND), U304.13 (~OE), U305.8 (GND), U305.13 (~OE), U306.8 (GND), U306.13 (~OE), U307.8 (GND), U307.13 (~OE), U308.8 (GND), U308.13 (~OE); also elsewhere on the board
unnamed: J307.1, R389.1
unnamed: J307.2, R391.1
unnamed: J308.1, R394.1
unnamed: J308.2, R396.1
unnamed: Q301.2 (B), R301.1, R302.1
unnamed: Q301.3 (C), R304.2
unnamed: Q302.2 (B), R303.2
unnamed: Q302.3 (C), R302.2
unnamed: Q303.2 (B), R305.2
unnamed: Q304.2 (B), R306.2
unnamed: Q305.2 (B), R307.2
unnamed: Q306.2 (B), R308.2
unnamed: Q307.2 (B), R309.2
unnamed: Q308.2 (B), R310.2
unnamed: Q309.2 (B), R311.2
unnamed: Q310.2 (B), R312.2
unnamed: Q311.2 (B), R313.2
unnamed: Q312.2 (B), R314.2
unnamed: Q313.2 (B), R315.2
unnamed: Q314.2 (B), R316.2
unnamed: Q315.2 (B), R317.2
unnamed: Q316.2 (B), R318.2
unnamed: Q317.2 (B), R319.2
unnamed: Q318.2 (B), R320.2
unnamed: Q319.2 (B), R321.1, R322.1
unnamed: Q319.3 (C), R324.2
unnamed: Q320.2 (B), R323.2
unnamed: Q320.3 (C), R322.2
unnamed: Q321.2 (B), R326.2
unnamed: Q322.2 (B), R327.2
unnamed: Q323.2 (B), R328.2
unnamed: Q324.2 (B), R329.2
unnamed: Q325.2 (B), R330.2
unnamed: Q326.2 (B), R331.2
unnamed: Q327.2 (B), R332.2
unnamed: Q328.2 (B), R333.2
unnamed: Q329.2 (B), R334.2
unnamed: Q330.2 (B), R335.2
unnamed: Q331.2 (B), R336.2
unnamed: Q332.2 (B), R337.2
unnamed: Q333.2 (B), R338.2
unnamed: Q334.2 (B), R339.2
unnamed: Q335.2 (B), R340.2
unnamed: Q336.2 (B), R341.2
unnamed: Q337.2 (B), R325.1, R342.1
unnamed: Q337.3 (C), R344.2
unnamed: Q338.2 (B), R343.2
unnamed: Q338.3 (C), R342.2
unnamed: Q339.2 (B), R345.1, R346.1
unnamed: Q339.3 (C), R348.2
unnamed: Q340.2 (B), R347.2
unnamed: Q340.3 (C), R346.2
unnamed: Q341.2 (B), R349.2
unnamed: Q342.2 (B), R350.2
unnamed: Q343.2 (B), R351.2
unnamed: Q344.2 (B), R352.2
unnamed: Q345.2 (B), R353.2
unnamed: Q346.2 (B), R354.2
unnamed: Q347.2 (B), R355.2
unnamed: Q348.2 (B), R356.2
unnamed: Q349.2 (B), R357.2
unnamed: Q350.2 (B), R358.2
unnamed: Q351.2 (B), R359.2
unnamed: Q352.2 (B), R360.2
unnamed: Q353.2 (B), R361.2
unnamed: Q354.2 (B), R362.2
unnamed: Q355.2 (B), R363.2
unnamed: Q356.2 (B), R364.2
unnamed: Q357.2 (B), R365.1, R366.1
unnamed: Q357.3 (C), R368.2
unnamed: Q358.2 (B), R367.2
unnamed: Q358.3 (C), R366.2
unnamed: Q359.2 (B), R369.1, R370.1
unnamed: Q359.3 (C), R388.2
unnamed: Q360.2 (B), R371.2
unnamed: Q361.2 (B), R372.2
unnamed: Q362.2 (B), R373.2
unnamed: Q363.2 (B), R374.2
unnamed: Q364.2 (B), R375.2
unnamed: Q365.2 (B), R376.2
unnamed: Q366.2 (B), R377.2
unnamed: Q367.2 (B), R378.2
unnamed: Q368.2 (B), R379.2
unnamed: Q369.2 (B), R380.2
unnamed: Q370.2 (B), R381.2
unnamed: Q371.2 (B), R382.2
unnamed: Q372.2 (B), R383.2
unnamed: Q373.2 (B), R384.2
unnamed: Q374.2 (B), R385.2
unnamed: Q375.2 (B), R386.2
unnamed: Q376.2 (B), R387.2
unnamed: Q376.3 (C), R370.2
unnamed: Q377.2 (B), R390.1, R392.1
unnamed: Q378.2 (B), R393.1
unnamed: Q378.3 (C), R392.2
unnamed: Q379.2 (B), R395.1, R397.1
unnamed: Q380.2 (B), R398.1
unnamed: Q380.3 (C), R397.2
unnamed: R305.1, U301.15 (QA)
unnamed: R306.1, U301.1 (QB)
unnamed: R307.1, U301.2 (QC)
unnamed: R308.1, U301.3 (QD)
unnamed: R309.1, U301.4 (QE)
unnamed: R310.1, U301.5 (QF)
unnamed: R311.1, U301.6 (QG)
unnamed: U301.9 (QH'), U303.14 (SER)
unnamed: R312.1, U301.7 (QH)
unnamed: R313.1, U302.15 (QA)
unnamed: R314.1, U302.1 (QB)
unnamed: R315.1, U302.2 (QC)
unnamed: R316.1, U302.3 (QD)
unnamed: R317.1, U302.4 (QE)
unnamed: R318.1, U302.5 (QF)
unnamed: R319.1, U302.6 (QG)
unnamed: U302.9 (QH'), U304.14 (SER)
unnamed: R320.1, U302.7 (QH)
unnamed: U302.14 (SER), U307.9 (QH')
unnamed: R326.1, U303.15 (QA)
unnamed: R327.1, U303.1 (QB)
unnamed: R328.1, U303.2 (QC)
unnamed: R329.1, U303.3 (QD)
unnamed: R330.1, U303.4 (QE)
unnamed: R331.1, U303.5 (QF)
unnamed: R332.1, U303.6 (QG)
unnamed: U303.9 (QH'), U305.14 (SER)
unnamed: R333.1, U303.7 (QH)
unnamed: R334.1, U304.15 (QA)
unnamed: R335.1, U304.1 (QB)
unnamed: R336.1, U304.2 (QC)
unnamed: R337.1, U304.3 (QD)
unnamed: R338.1, U304.4 (QE)
unnamed: R339.1, U304.5 (QF)
unnamed: R340.1, U304.6 (QG)
unnamed: U304.9 (QH'), U306.14 (SER)
unnamed: R341.1, U304.7 (QH)
unnamed: R349.1, U305.15 (QA)
unnamed: R350.1, U305.1 (QB)
unnamed: R351.1, U305.2 (QC)
unnamed: R352.1, U305.3 (QD)
unnamed: R353.1, U305.4 (QE)
unnamed: R354.1, U305.5 (QF)
unnamed: R355.1, U305.6 (QG)
unnamed: U305.9 (QH'), U307.14 (SER)
unnamed: R356.1, U305.7 (QH)
unnamed: R357.1, U306.15 (QA)
unnamed: R358.1, U306.1 (QB)
unnamed: R359.1, U306.2 (QC)
unnamed: R360.1, U306.3 (QD)
unnamed: R361.1, U306.4 (QE)
unnamed: R362.1, U306.5 (QF)
unnamed: R363.1, U306.6 (QG)
unnamed: U306.9 (QH'), U308.14 (SER)
unnamed: R364.1, U306.7 (QH)
unnamed: R371.1, U307.15 (QA)
unnamed: R372.1, U307.1 (QB)
unnamed: R373.1, U307.2 (QC)
unnamed: R374.1, U307.3 (QD)
unnamed: R375.1, U307.4 (QE)
unnamed: R376.1, U307.5 (QF)
unnamed: R377.1, U307.6 (QG)
unnamed: R378.1, U307.7 (QH)
unnamed: R379.1, U308.15 (QA)
unnamed: R380.1, U308.1 (QB)
unnamed: R381.1, U308.2 (QC)
unnamed: R382.1, U308.3 (QD)
unnamed: R383.1, U308.4 (QE)
unnamed: R384.1, U308.5 (QF)
unnamed: R385.1, U308.6 (QG)
unnamed: R386.1, U308.7 (QH)

Notes on the sheet:
Cathode Drivers
