Synthron/Nixie/Hardware/PCB/nixie.kicad_pcb

## KiCad design Hardware/PCB/nixie.kicad_pcb (continued)


Parts:
J201: Hr_Ten; PinSocket_1x12_P2.54mm_Vertical
J202: Hr_One; PinSocket_1x12_P2.54mm_Vertical
J203, J206: Min_dot; PinSocket_1x04_P2.54mm_Vertical
J204: Min_Ten; PinSocket_1x12_P2.54mm_Vertical
J205: Min_One; PinSocket_1x12_P2.54mm_Vertical
J207: Sec_Ten; PinSocket_1x12_P2.54mm_Vertical
J208: Sec_One; PinSocket_1x12_P2.54mm_Vertical
NE201, NE202, NE203, NE204: NE-2; Valve_Glimm
U201, U202, U203, U204, U205, U206: Z5600M; B13B

Connections:
unnamed: J201.1, U201.13 (Seg1)
unnamed: J201.2, U201.12 (Seg2)
unnamed: J201.3, U201.11 (Seg3)
unnamed: J201.4, U201.10 (Seg4)
unnamed: J201.5, U201.9 (Seg5)
unnamed: J201.6, U201.7 (Seg6)
unnamed: J201.7, U201.6 (Seg7)
unnamed: J201.8, U201.5 (Seg8)
unnamed: J201.9, U201.4 (Seg9)
unnamed: J201.10, U201.3 (Seg0)
unnamed: J201.12, U201.2 (A)
unnamed: J202.1, U202.13 (Seg1)
unnamed: J202.2, U202.12 (Seg2)
unnamed: J202.3, U202.11 (Seg3)
unnamed: J202.4, U202.10 (Seg4)
unnamed: J202.5, U202.9 (Seg5)
unnamed: J202.6, U202.7 (Seg6)
unnamed: J202.7, U202.6 (Seg7)
unnamed: J202.8, U202.5 (Seg8)
unnamed: J202.9, U202.4 (Seg9)
unnamed: J202.10, U202.3 (Seg0)
unnamed: J202.12, U202.2 (A)
unnamed: J203.1, NE202.2
unnamed: J203.2, NE201.2
unnamed: J203.4, NE201.1, NE202.1
unnamed: J204.1, U203.13 (Seg1)
unnamed: J204.2, U203.12 (Seg2)
unnamed: J204.3, U203.11 (Seg3)
unnamed: J204.4, U203.10 (Seg4)
unnamed: J204.5, U203.9 (Seg5)
unnamed: J204.6, U203.7 (Seg6)
unnamed: J204.7, U203.6 (Seg7)
unnamed: J204.8, U203.5 (Seg8)
unnamed: J204.9, U203.4 (Seg9)
unnamed: J204.10, U203.3 (Seg0)
unnamed: J204.12, U203.2 (A)
unnamed: J205.1, U204.13 (Seg1)
unnamed: J205.2, U204.12 (Seg2)
unnamed: J205.3, U204.11 (Seg3)
unnamed: J205.4, U204.10 (Seg4)
unnamed: J205.5, U204.9 (Seg5)
unnamed: J205.6, U204.7 (Seg6)
unnamed: J205.7, U204.6 (Seg7)
unnamed: J205.8, U204.5 (Seg8)
unnamed: J205.9, U204.4 (Seg9)
unnamed: J205.10, U204.3 (Seg0)
unnamed: J205.12, U204.2 (A)
unnamed: J206.1, NE204.2
unnamed: J206.2, NE203.2
unnamed: J206.4, NE203.1, NE204.1
unnamed: J207.1, U205.13 (Seg1)
unnamed: J207.2, U205.12 (Seg2)
unnamed: J207.3, U205.11 (Seg3)
unnamed: J207.4, U205.10 (Seg4)
unnamed: J207.5, U205.9 (Seg5)
unnamed: J207.6, U205.7 (Seg6)
unnamed: J207.7, U205.6 (Seg7)
unnamed: J207.8, U205.5 (Seg8)
unnamed: J207.9, U205.4 (Seg9)
unnamed: J207.10, U205.3 (Seg0)
unnamed: J207.12, U205.2 (A)
unnamed: J208.1, U206.13 (Seg1)
unnamed: J208.2, U206.12 (Seg2)
unnamed: J208.3, U206.11 (Seg3)
unnamed: J208.4, U206.10 (Seg4)
unnamed: J208.5, U206.9 (Seg5)
unnamed: J208.6, U206.7 (Seg6)
unnamed: J208.7, U206.6 (Seg7)
unnamed: J208.8, U206.5 (Seg8)
unnamed: J208.9, U206.4 (Seg9)
unnamed: J208.10, U206.3 (Seg0)
unnamed: J208.12, U206.2 (A)

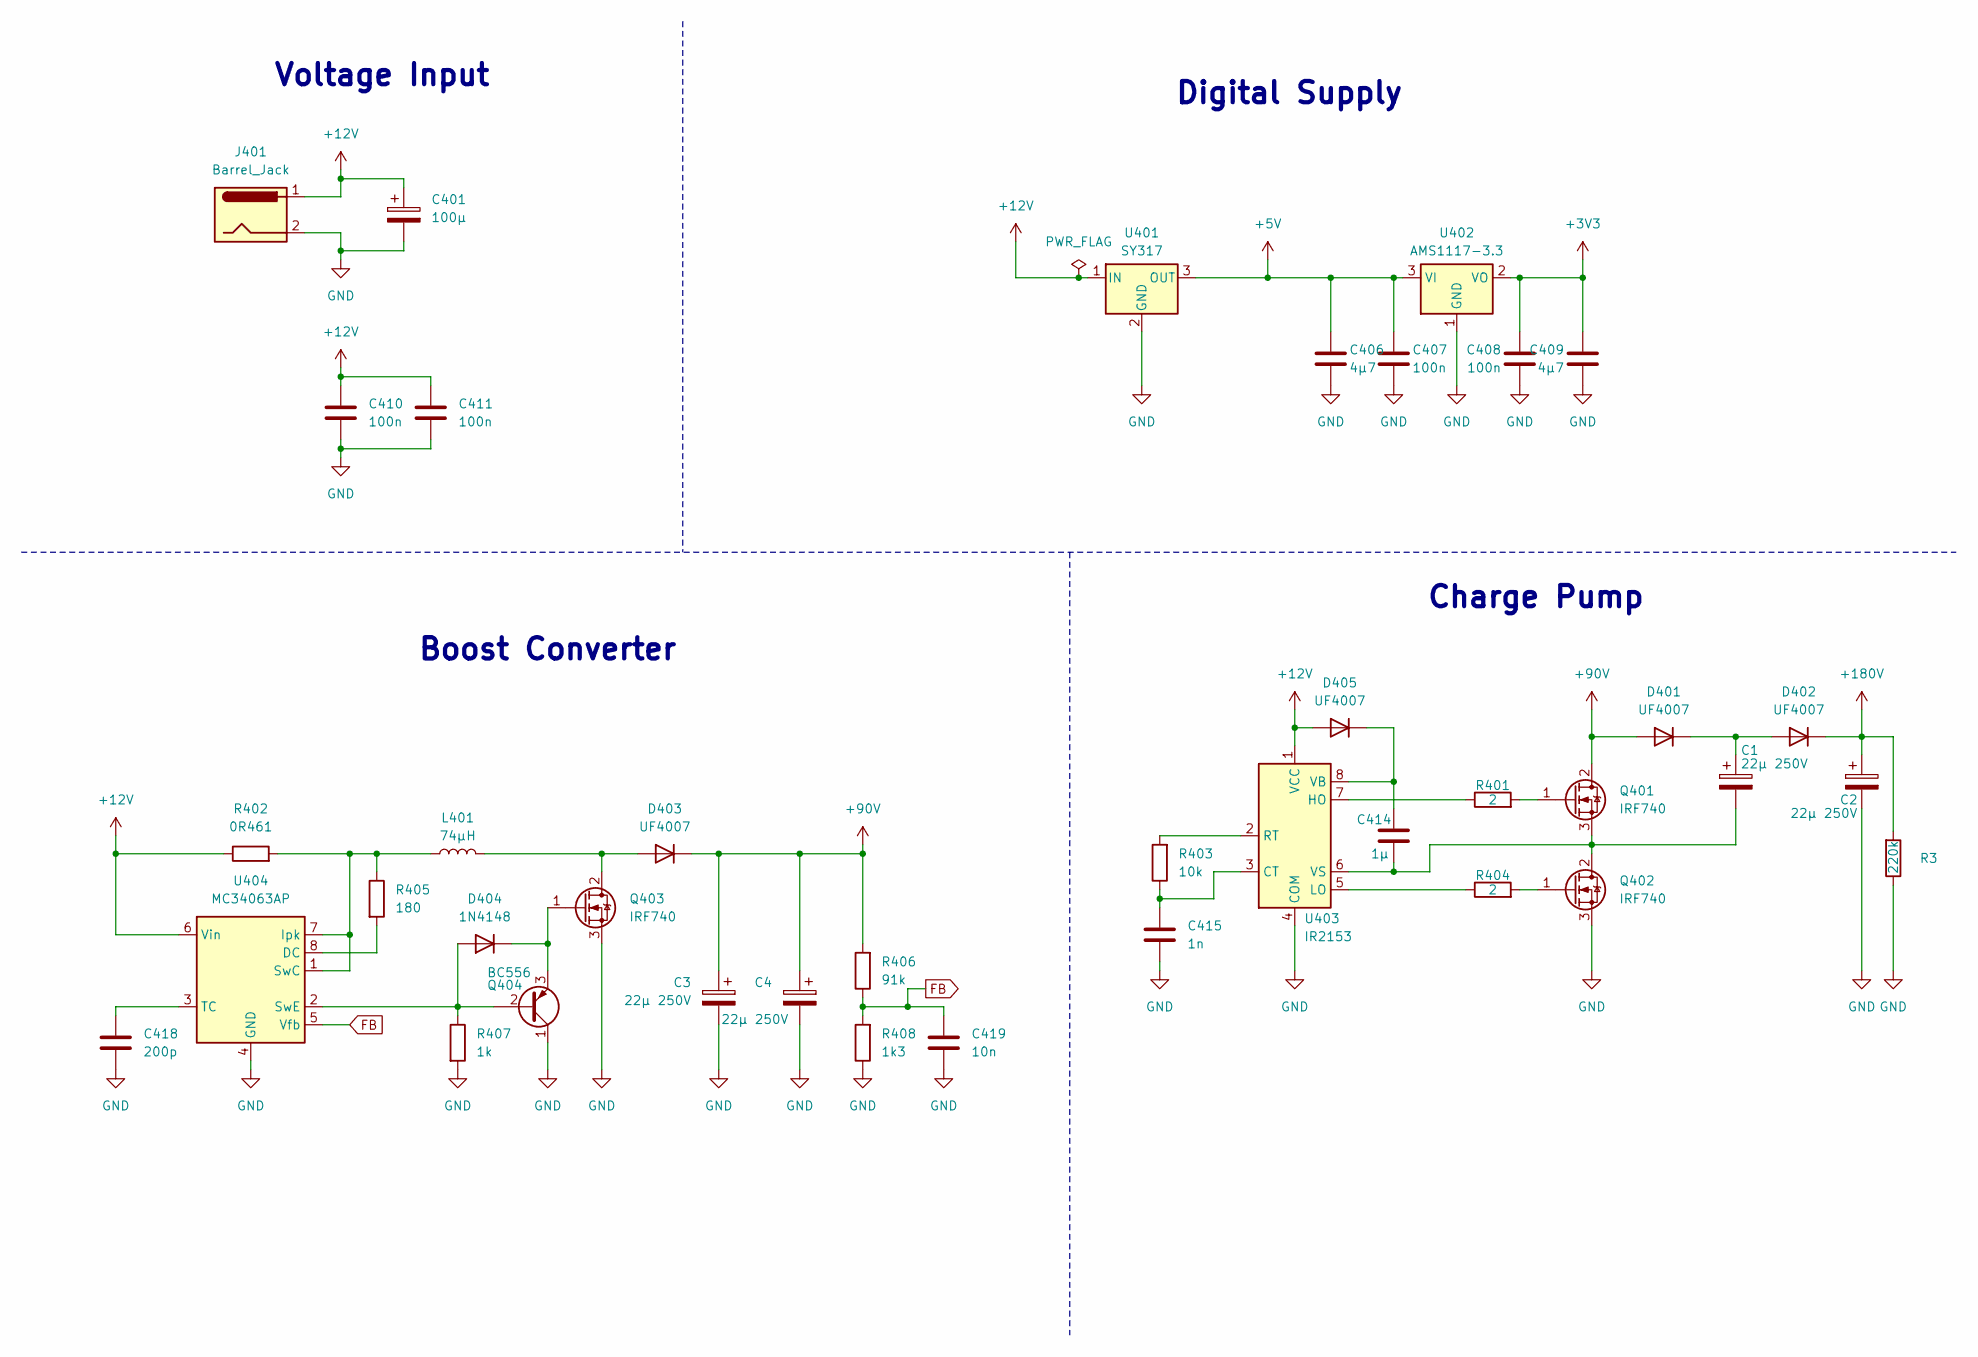
[picture p18: schematic psu.kicad_sch, Z5600M Nixie Clock with ESP32]

Parts:
C1, C2, C3, C4: 22µ 250V; CP_Radial_D10.0mm_P5.00mm
C401: 100µ; CP_Radial_D5.0mm_P2.50mm
C406, C409: 4µ7; C_0805_2012Metric
C407, C408: 100n; C_0805_2012Metric
C410, C411: 100n; C_Disc_D3.0mm_W1.6mm_P2.50mm
C414: 1µ; C_Rect_L18.0mm_W8.0mm_P15.00mm_FKS3_FKP3
C415: 1n; C_Disc_D3.0mm_W1.6mm_P2.50mm
C418: 200p; C_Disc_D3.0mm_W1.6mm_P2.50mm
C419: 10n; C_Disc_D3.0mm_W1.6mm_P2.50mm
D401, D402, D403, D405: UF4007; D_DO-41_SOD81_P10.16mm_Horizontal
D404: 1N4148; D_DO-35_SOD27_P7.62mm_Horizontal
J401: Barrel_Jack; BarrelJack_Horizontal
L401: 74µH; FT50-43
Q401, Q402, Q403: IRF740; TO-220-3_Vertical
Q404: BC556; TO-92
R3: 220k; R_Axial_DIN0207_L6.3mm_D2.5mm_P2.54mm_Vertical
R401, R404: 2; R_Axial_DIN0207_L6.3mm_D2.5mm_P2.54mm_Vertical
R402: 0R461; R_Axial_DIN0614_L14.3mm_D5.7mm_P5.08mm_Vertical
R403: 10k; R_Axial_DIN0207_L6.3mm_D2.5mm_P2.54mm_Vertical
R405: 180; R_Axial_DIN0207_L6.3mm_D2.5mm_P2.54mm_Vertical
R406: 91k; R_Axial_DIN0207_L6.3mm_D2.5mm_P2.54mm_Vertical
R407: 1k; R_Axial_DIN0207_L6.3mm_D2.5mm_P2.54mm_Vertical
R408: 1k3; R_Axial_DIN0207_L6.3mm_D2.5mm_P2.54mm_Vertical
U401: SY317; TO-220-3_Vertical
U402: AMS1117-3.3; SOT-223-3_TabPin2
U403: IR2153; DIP-8_W7.62mm
U404: MC34063AP; DIP-8_W7.62mm

Connections:
+3V3: C408.1, C409.1, U402.2 (VO); also elsewhere on the board
+5V: C406.1, C407.1, U401.3 (OUT), U402.3 (VI); also elsewhere on the board
+12V: C401.1, C410.1, C411.1, D405.2 (A), J401.1, R402.1, U401.1 (IN), U403.1 (VCC), U404.6 (Vin)
+90V: C3.1, C4.1, D401.2 (A), D403.1 (K), Q401.2 (D), R406.2
+180V: C2.1, D402.1 (K), R3.2; also elsewhere on the board
FB: C419.1, R406.1, R408.2, U404.5 (Vfb)
GND: C2.2, C3.2, C4.2, C401.2, C406.2, C407.2, C408.2, C409.2, C410.2, C411.2, C415.2, C418.2, C419.2, J401.2, Q402.3 (S), Q403.3 (S), Q404.1 (C), R3.1, R407.2, R408.1, U401.2 (GND), U402.1 (GND), U403.4 (COM), U404.4 (GND); also elsewhere on the board
unnamed: C1.1, D401.1 (K), D402.2 (A)
unnamed: D403.2 (A), L401.2, Q403.2 (D)
unnamed: D404.2 (A), Q404.2 (B), R407.1, U404.2 (SwE)
unnamed: D404.1 (K), Q403.1 (G), Q404.3 (E)
unnamed: C414.1, D405.1 (K), U403.8 (VB)
unnamed: Q401.1 (G), R401.2
unnamed: C1.2, C414.2, Q401.3 (S), Q402.2 (D), U403.6 (VS)
unnamed: Q402.1 (G), R404.2
unnamed: C415.1, R403.1, U403.3 (CT)
unnamed: R401.1, U403.7 (HO)
unnamed: R404.1, U403.5 (LO)
unnamed: R403.2, U403.2 (RT)
unnamed: R405.2, U404.8 (DC)
unnamed: L401.1, R402.2, R405.1, U404.1 (SwC), U404.7 (Ipk)
unnamed: C418.1, U404.3 (TC)

Notes on the sheet:
Digital Supply
Boost Converter
Charge Pump
Voltage Input

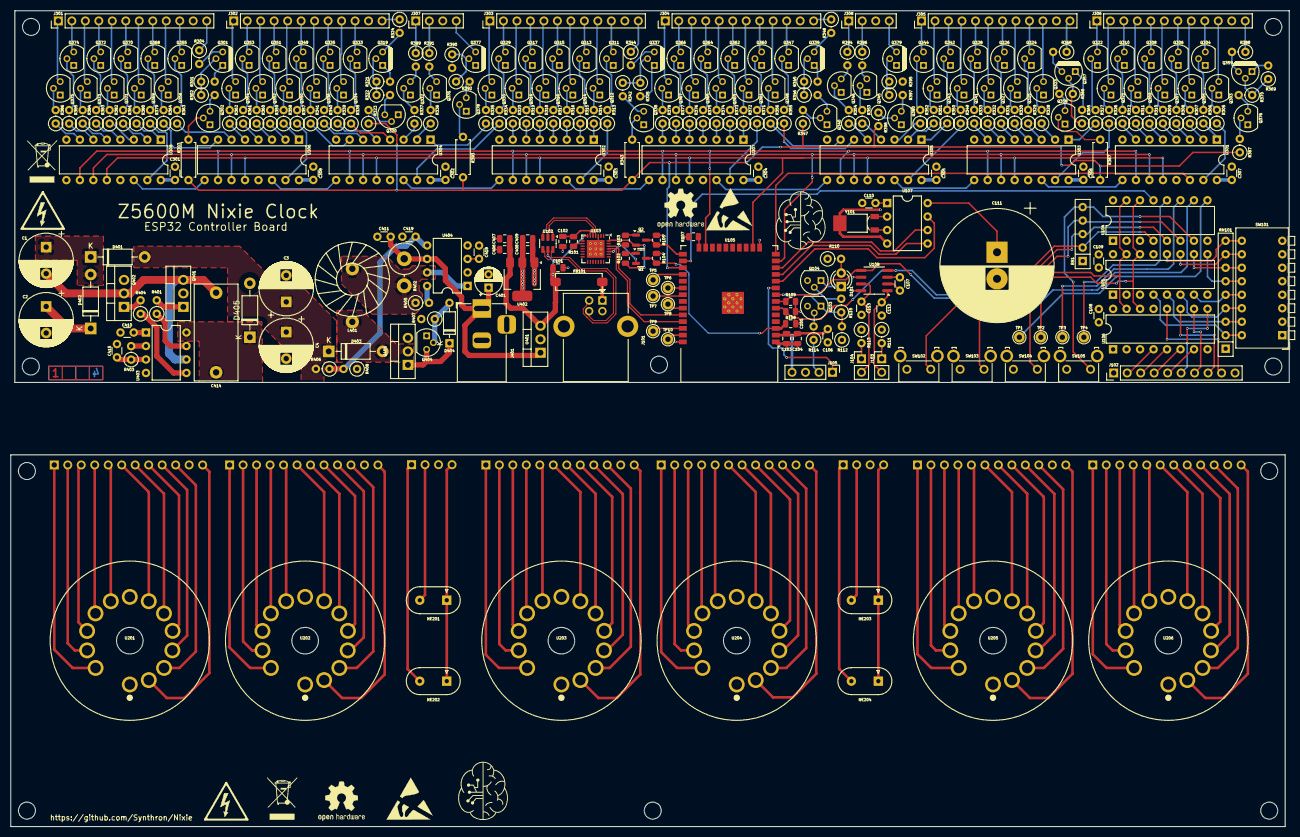
[picture p19: board nixie.kicad_pcb from above]

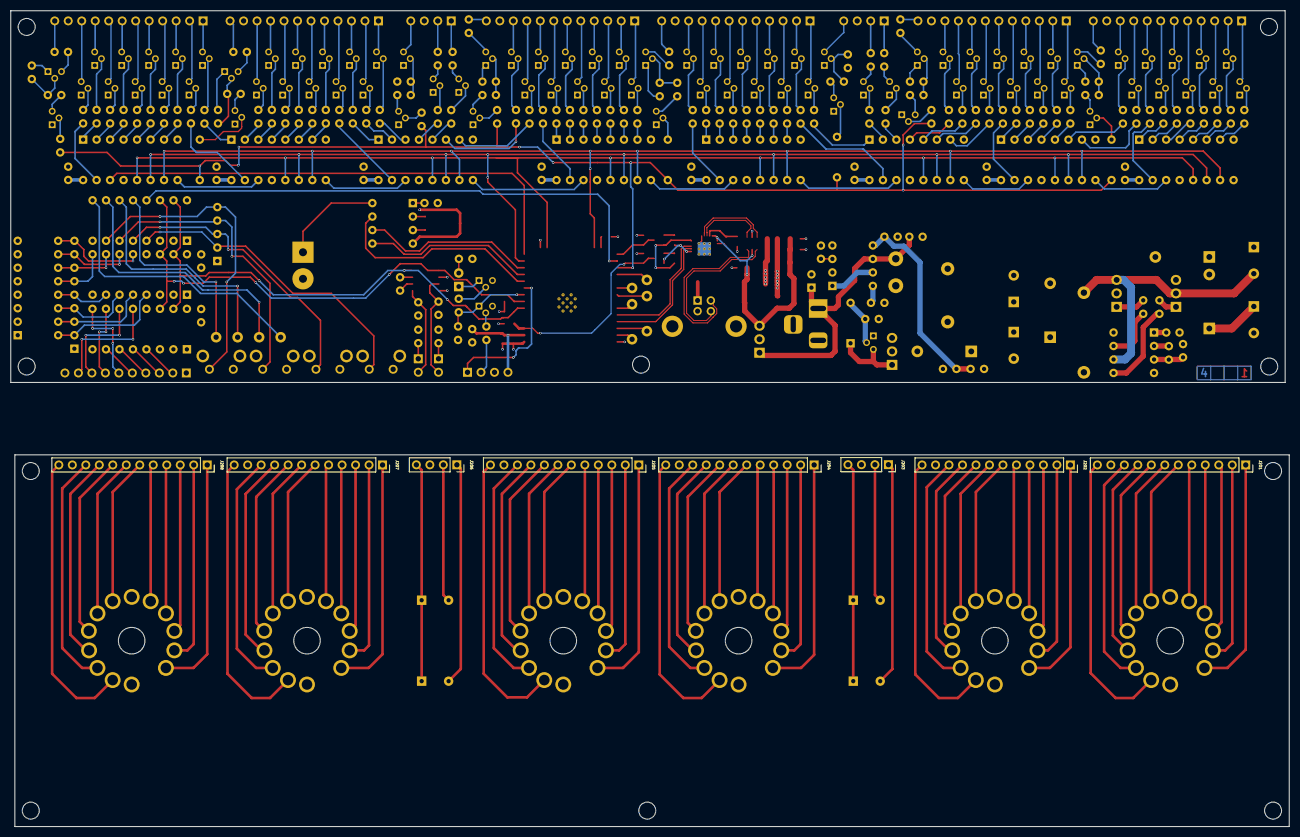
[picture p20: board nixie.kicad_pcb from below]

Board: 4 copper layers, 240.0 x 70.0 mm, 323 parts (8 on the bottom side), 406 nets.

Other parts of the board:
Ref**: Val**; ladder_4
