Synthron/Nixie/Software/Nixie/src/main.cpp

#include "main.h"
#include "config.h"

Clock nixie;

// Class Objects
Wifi wifi;

TaskHandle_t WebTasks;
struct tm timeinfo;

//DS1302 Classes
DS1302 DS_RTC;
mytimeinfo nix_time;

ESP32Time int_rtc;
// variables

const char *ntpServer = "pool.ntp.org";
// NTP fetches true UTC; the user timezone offset is applied once in update_time()
// via time_offset (single source of truth). gmtOffset_sec must stay 0 to avoid a
// double shift when time_offset is non-zero.
const long gmtOffset_sec = 0;
int daylightOffset_sec = 0;

//bootstrap flags
bool ntp=1;
bool dcf=0;
bool ldr=0;
bool t1=0;
bool t2=0;
bool dimm=1;
bool rtc=0;
bool usb=1;

int8_t time_offset = 0;   // user timezone offset in hours applied to the base (UTC) time

bool dim_once;
bool half = false;

bool boot;

//isr flags
uint8_t ms500_cycle = 0;
volatile bool btn_irq;

//misc
uint8_t k = 0;
uint8_t T1_Temp, T2_Temp;
float ldr_log;

hw_timer_t *Timer_Channel1 = NULL;

void setup()
{
  boot = 1;
  read_Straps();

  if(usb) Serial.begin(115200);
  USBLN("Booting...");
  
  //File System Init
  USBLN("Setup File Systems");

  if (!SPIFFS.begin(FORMAT_SPIFFS_IF_FAILED))
  {
    USBLN("SPIFFS Mount Failed");
    ESP.restart();
  }
  USBLN("SPIFFS mounted");

  //Setup IO pins
  pinConfig();

  //Load all settings (wifi, brightness, timezone offset) from the SPIFFS config file
  config_load();

  //Dimming Enable
  if(dimm)
  {
    analogWriteFrequency(100);
    analogWrite(PIN_PWM, 0);
  }
  else
  {
    analogWriteFrequency(100);
    analogWrite(PIN_PWM, nixie.pwm);
  }

  if(ntp)
  {
    wifi_setup();
    ntp_setup();
  }

  //RTC Enable and Initial Read
  //If RTC empty, clock starts at 00:00:00
  //RTC can be set via NTP, DCF or manually
  if(rtc)
  {
    DS_RTC.init(PIN_RTCIO, PIN_RTCCLK, PIN_RTCCE1);
    DS_RTC.enableCharging();
    if(ntp) 
    {
      DS_RTC.setTime(nix_time);
      USB("Saving internallay\r\nTime: %2d:%2d:%2d\r\nDate: %2d.%2d.%2d\r\nDay: %d\r\n",nix_time.hours, nix_time.minutes, nix_time.seconds, nix_time.date, nix_time.month, nix_time.year, nix_time.wday);
    }
    else nix_time = DS_RTC.getTime();
  }

  rtc_setup();



  //setup Timers
  //Channel 1: 500ms timer
/*
  Timer_Channel1 = timerBegin(0, 80, true);
  timerAlarmWrite(Timer_Channel1, 500000, true);
  timerAttachInterrupt(Timer_Channel1, &timer1, true);
  timerAlarmEnable(Timer_Channel1);
*/

  //setup Button Input Interrupts
  pinMode(PIN_INT, INPUT_PULLUP);
  attachInterrupt(PIN_INT, &input_isr, GPIO_INTR_NEGEDGE);

  USBLN("Booting complete");

  boot = 0;

  if(t1) start_adc(0, 0);
}

void loop()
{
  update_time();

  if(btn_irq)
  {
    handle_menu();
  }

// Half Second Cycle
  if(!menu_is_active())
  {
    if ((int_rtc.getMillis()<500) && !half)
    {
      nixie.mode = nixie.d_on;
      if (t1)T1_Temp = get_temp(read_adc(), 0);
      if (ldr || t2) start_adc(1, 0);
      dim_once = 0;
      half = 1;
    }
    if((int_rtc.getMillis()>500) && half)
    {
      nixie.mode = nixie.d_off;
      if (ldr) ldr_log = log10(read_adc()) - 1;
      else if(t2) T2_Temp = get_temp(read_adc(), 1);
      if (t1) start_adc(0, 0);
      half = 0;
    }
  // Display Mode
    if(nixie.dis_mode == 0)
    {
      if((int_rtc.getMillis()>500) && (nixie.mode == nixie.d_on))
      {
        nixie.mode = nixie.d_off;
      }
      else if ((int_rtc.getMillis()<500) && (nixie.mode == nixie.d_off))
      {
        nixie.mode = nixie.d_on;
      }
      nixie.show_time(nix_time);
    }
    else if(nixie.dis_mode == 1)
    {
      nixie.mode = nixie.d_date;
      nixie.show_date(nix_time);

    }
    else if (nixie.dis_mode == 2)
    {
      start_adc(0, 0);
      if(int_rtc.getMillis() > 900)
        T1_Temp = get_temp(read_adc(), 0);
      nixie.show_temp(T1_Temp, 0);
    }
    else if (nixie.dis_mode == 3)
    {
      start_adc(1, 0);
      if(int_rtc.getMillis() > 900)
        T2_Temp = get_temp(read_adc(), 1);
      nixie.show_temp(T2_Temp, 1);
    }
  }
  else
  {
    menu_update_display();
  }


  if(!menu_is_active())
  {
    if (rtc)
    {
      if(nix_time.minutes == 0 && nix_time.seconds == 0)
      {
        nix_time = DS_RTC.getTime();
        int_rtc.setTime(nix_time.seconds, nix_time.minutes, nix_time.hours, nix_time.date, nix_time.month, nix_time.year + 2000);
        USB("syncing time from external rtc\r\nTime: %2d:%2d:%2d\r\nDate: %2d.%2d.%2d\r\n",nix_time.hours, nix_time.minutes, nix_time.seconds, nix_time.date, nix_time.month, nix_time.year);
      }
    }
    //if enabled, fetch the network time daily at 00:00:00 and sync every hour with external RTC
    if(ntp)
    {
      if(nix_time.hours == 0 && nix_time.minutes == 0 && nix_time.seconds == 0)
      {
        ntp_setup();
        int_rtc.setTime(nix_time.seconds, nix_time.minutes, nix_time.hours, nix_time.date, nix_time.month, nix_time.year + 2000);
        if(rtc)
        {
          DS_RTC.setTime(nix_time);
        }
      }
    }

    //cycle filaments every ten minutes to counter cathode poisoning
    //cycle(5) holds each of the 10 filaments for 5 seconds
    if(nix_time.minutes % 10 == 0 && nix_time.seconds <= 30)
      nixie.cycle(5);

    if(dimm && (int_rtc.getMillis() > 900) && !dim_once)
    {
      dimming();
      dim_once = true;
    }
  }
}

void write_Registers(uint64_t data)
{
  for (uint8_t i = 0; i < 64; i++)
  {
    digitalWrite(PIN_DAT, data & 0x01);
    digitalWrite(PIN_SCLK, HIGH);
    delayMicroseconds(1);
    digitalWrite(PIN_SCLK, LOW);
    delayMicroseconds(1);
    data = data >> 1;
  }
  digitalWrite(PIN_RCLK, HIGH);
  delayMicroseconds(1);
  digitalWrite(PIN_RCLK, LOW);
  delayMicroseconds(1);
}

// Run OTA and Web Service on different core than main loop
void Web_Tasks(void *pvParameters)
{
  for (;;)
  {
    ArduinoOTA.handle();
    web_server_handle();
    vTaskDelay(1);
  }
}

void handle_menu()
{
  uint8_t input_no = 0;
  //debounce
  delay(10);
  //read input register, clear !INT signal
  Wire.requestFrom(ADDR_INPUT, 1);
  uint8_t reg_input = ~Wire.read();
  Wire.endTransmission();

  //check if and which button is pressed
  if(reg_input)
  {
    //check if source was first button (MODE)
    if(reg_input & 0x01)
    {
      input_no = 1;
    }
    //check if source was second button (UP)
    else if (reg_input & 0x02)
    {
      input_no = 2;
    }
    //check if source was third button (DOWN)
    else if (reg_input & 0x04)
    {
      input_no = 3;
    }
    //check if source was fourth button (ENTER)
    else if (reg_input & 0x08)
    {
      input_no = 4;
    }
  }

  //route the button press to the menu state machine
  menu_handle_button(input_no);

  //reset flag
  btn_irq = 0;
}

void update_time()
{
  // base UTC time from the internal RTC
  time_t base = int_rtc.getEpoch();
  // apply the user timezone offset (may cross the dateline)
  time_t shifted = base + (time_t)time_offset * 3600;

  // extract the shifted fields deterministically (UTC interpretation,
  // independent of the system timezone set by configTime)
  struct tm t;
  gmtime_r(&shifted, &t);

  nix_time.hours    = t.tm_hour;
  nix_time.minutes  = t.tm_min;
  nix_time.seconds  = t.tm_sec;
  nix_time.date     = t.tm_mday;
  nix_time.month    = t.tm_mon + 1;
  nix_time.year     = t.tm_year % 100;
  nix_time.wday     = t.tm_wday + 1;
}

// Setup Functions

//Bootstrap
void read_Straps()
{
    //IO Expander
  Wire.begin(PIN_TP1, PIN_TP0);
  
  //Read bootstraps
  Wire.requestFrom(ADDR_CONFIG, 1);
  uint8_t temp_strap = ~Wire.read();
  Wire.endTransmission();

  ntp  =  temp_strap       & 0x01;
  dcf  = (temp_strap >> 1) & 0x01;
  dimm = (temp_strap >> 2) & 0x01;
  t1   = (temp_strap >> 3) & 0x01;
  t2   = (temp_strap >> 4) & 0x01;
  ldr  = (temp_strap >> 5) & 0x01;
  rtc  = (temp_strap >> 6) & 0x01;
  usb  = (temp_strap >> 7) & 0x01;
}

void pinConfig()
{
  USBLN("IO Config");
  //74HC595 pins 
  pinMode(PIN_SCLR, OUTPUT);
  pinMode(PIN_SCLK, OUTPUT);
  pinMode(PIN_RCLK, OUTPUT);
  pinMode(PIN_DAT, OUTPUT);

  digitalWrite(PIN_SCLR, LOW);
  digitalWrite(PIN_DAT, LOW);
  digitalWrite(PIN_SCLK, LOW);
  digitalWrite(PIN_RCLK, LOW);  
  delayMicroseconds(1);
  digitalWrite(PIN_RCLK, HIGH);
  delayMicroseconds(1);
  digitalWrite(PIN_RCLK, LOW);
  digitalWrite(PIN_SCLR, HIGH);

  //DS1302 Pins
  pinMode(PIN_RTCCE1, OUTPUT);
  pinMode(PIN_RTCCLK, OUTPUT);
  pinMode(PIN_RTCIO, OUTPUT);

  digitalWrite(PIN_RTCCE1, LOW);
  digitalWrite(PIN_RTCCLK, LOW);
  digitalWrite(PIN_RTCIO,  LOW);

  //PWM Pin
  pinMode(PIN_PWM, OUTPUT);
  digitalWrite(PIN_PWM, HIGH);

}

void ntp_setup()
{
  USBLN("Update Time Data");
  configTime(gmtOffset_sec, daylightOffset_sec, ntpServer);
  if (!getLocalTime(&timeinfo))
  {
    USBLN("Failed to obtain time, setting 01-01-2000 00:00:00");
    ntp = 0;
  }
  else
  {
    USBLN(&timeinfo, "%A, %B %d %Y %H:%M:%S");
    USBLN(timeinfo.tm_mon, DEC);

    //update time info of nixie class
    nix_time.hours = timeinfo.tm_hour;
    nix_time.minutes = timeinfo.tm_min;
    nix_time.seconds = timeinfo.tm_sec;
    nix_time.date = timeinfo.tm_mday;
    nix_time.month = timeinfo.tm_mon+1;
    nix_time.year = timeinfo.tm_year % 100;
    nix_time.wday = timeinfo.tm_wday+1;
  }
}

void rtc_setup()
{
  setExternalCrystalAsRTCSource();

  USB("storing internally\r\nTime: %2d:%2d:%2d\r\nDate: %2d.%2d.%2d\r\n",nix_time.hours, nix_time.minutes, nix_time.seconds, nix_time.date, nix_time.month, nix_time.year);

  int_rtc.setTime(nix_time.seconds, nix_time.minutes, nix_time.hours, nix_time.date, nix_time.month, nix_time.year + 2000);
}

void wifi_setup()
{
  USBLN("Setup WiFi");

  wifi_start(wifi);

  USBPR("IP address: ");
  USBLN(WiFi.localIP());

  ota_start();
  USBLN("OTA Start");

  delay(500);

  // create special task for OTA and Webserver on seperate core
  xTaskCreatePinnedToCore(
      Web_Tasks, /* Task function. */
      "Web_OTA", /* name of task. */
      10000,     /* Stack size of task */
      NULL,      /* parameter of the task */
      1,         /* priority of the task */
      &WebTasks, /* Task handle to keep track of created task */
      0);        /* pin task to core 0 */
  delay(500);

}

// ADC Functions
void start_adc(bool channel, bool continuous)
{
  //0b S C1 C0 O/C S1 S0 G1 G0
  //start conversion in OneShot Mode
  uint8_t config_reg = 0x80;
  //select channel
  config_reg |= (uint8_t)channel << 5;

  //set sample mode
  if(continuous)
    config_reg |= 0x10;
  
  //set sample rate and resolution 15SPS 16bit
  config_reg |= 0x08;

  Wire.beginTransmission(ADDR_ADC);
  Wire.write(config_reg);
  Wire.endTransmission();
}

uint16_t read_adc()
{
  uint8_t d_high, d_low, conf;
  Wire.requestFrom(ADDR_ADC, 3);
  d_high = Wire.read();
  d_low = Wire.read();
  conf = Wire.read();
  Wire.endTransmission();

  return ((uint16_t)d_high << 8) + d_low;
}

uint8_t get_temp(uint16_t adc, bool channel)
{
  float a = 0.0039083;
  float ref = 2.048;
  float fac = ref / 32768;
  float volt = adc * fac;

  float rt = (3.3 - volt) / (volt / 100);
  float temp = ((rt / 100) - 1) / a;

  // apply the channel-specific offset
  temp -= (channel == 0) ? T1_Offset : T2_Offset;

  // clamp to the displayable range (0..99) to avoid negative wrap-around
  if (temp < 0) temp = 0;
  if (temp > 99) temp = 99;

  return (uint8_t)(temp + 0.5);
}

void dimming()
{
  uint8_t pwm_fac;

  if(ldr_log > 4.0)
    ldr_log = 4.0;

  pwm_fac = (uint8_t)(20.0 * ldr_log);

  if(pwm_fac < 16)
    pwm_fac = 16;

  analogWrite(PIN_PWM, pwm_fac);

}

// ISR FUnctions

void IRAM_ATTR timer1()
{
  //ms500_cycle++;
}

void IRAM_ATTR input_isr()
{
  btn_irq = 1;
}
