Synthron/Nixie/(commit log)

2024-09-16 first schematic draft
    [driver.kicad_sch, h3161-01.stp, nixie.kicad_pcb, nixie.kicad_sch, nixies.kicad_sch, psu.kicad_sch]
2024-09-17 schematic update
    [driver.kicad_sch, nixie.kicad_sch, nixies.kicad_sch, psu.kicad_sch]
2024-09-18 Hardware Update Schematic Done Placement started
    [SY317.step, driver.kicad_sch, nixie.kicad_pcb, nixie.kicad_sch, nixies.kicad_sch, psu.kicad_sch]
2024-09-22 PCB update finished placing and routing Cleanup Passes need to be done Silkscreen needs to be done
    [NE-2 - Neon.STEP, SMB-002.stp, USB-B-S-F-B-TH.stp, driver.kicad_sch, nixie.kicad_pcb, nixie.kicad_sch, psu.kicad_sch]
2024-09-23 PCB Update Silkscreen cleanup Layout Cleanup concept front plate
    [nixie.kicad_pcb, nixie.kicad_sch]
2024-09-29 small bugfix update
    [nixie.kicad_pcb, psu.kicad_sch]
2024-10-03 reviewed version from thebrutzler
    [driver.kicad_sch, nixie.kicad_sch, nixies.kicad_sch, psu.kicad_sch]
2024-10-05 Major Final Update Finalize design check all changes made during review revert back Footprint of Inductor Split PCB design into two projects add some functionality to ESP32 (Bootstrap and crystal)
    [nixie.kicad_sch, nixies.kicad_pcb, nixies.kicad_sch, psu.kicad_sch]
2024-10-15 create dot spacer
    [dots_spacer.3mf]
2024-10-17 refactor code get tick from RTC optimize boot queue optimize button interface
2024-10-17 make PWM adjustable via buttons
2024-10-18 Small Code Update bugfix month number display implemented daily internal synchronization
    [main.cpp]
2024-10-18 Bugfix RTC Oscillator Calibration
    [main.cpp, main.h, myrtc.cpp, myrtc.h]
2024-10-18 Code Update RTC bugfix boot sequence trying to write to RTC when not initialized yet Cleanup of Class Function
    [classes.cpp, classes.h, main.cpp]
2024-10-18 bugfix at synchronization funcion and cycle function
    [main.cpp]
2024-10-19 Bugfix external RTC Communication
    [classes.cpp, main.cpp, myrtc.cpp]
2024-10-20 bugfix on setting rtc
    [main.cpp, myrtc.cpp]
2024-10-20 bugfixes of month calculation, DST calculation, boot strapping
    [classes.cpp, main.cpp, main.h]
2024-10-20 crude 3d printed spacers with isolation for pin headers
    [back_cover.3mf, front_cover.3mf]
2024-10-21 add FreeCAD files
    [covers.FCStd, dots_spacer.FCStd]
2024-10-23 Code Update Implement ADC read Implement PT100 Display Implement LDR & automatic dimming
    [nixie.kicad_sch]
2024-10-25 bugfix in DST calculation
    [main.cpp]
2024-12-15 Optimizations disable DST do number cycling every hour for 2 minutes to fix cathode poisoning issue
    [classes.cpp, main.cpp]
2025-01-03 small code update bugfix for wrong month display added more filament cycle time for cathode poisoning prevention
    [classes.cpp, classes.h, main.cpp, myrtc.cpp]
2025-06-19 add quick fix for DST, press MODE button to toggle DST
2026-10-13 Refactor menu and timezone handling; fix 32kHz crystal boot
    Menu rework:
    - Select modes 1-4 via UP/DOWN in mode-select (MODE now exits to idle)
    - Blank hours/minutes in mode-select; show only the mode number on the
    single-seconds digit (new blink_field 5)
    - Add menu mode 4: Set Offset (user timezone offset in hours)
    - Brightness mode: show the value 00-99 on all three tube sets and apply
    the PWM live on every press
    - Outside the menu, ENTER cycles the display: Time -> Date -> Temp1 (if
    t1) -> Temp2 (if t2)
    Timezone: replace DST switch with a general offset
    - Remove check_DST()/set_DST() and the dst/dst_last booleans
    - Add int8_t time_offset (range -12..+14), persisted in EEPROM
    - upda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
2026-10-13 feat(networking): add AP-mode WiFi manager with network scan and drop network.h
    Replace the hardcoded network.h credentials with a runtime WiFi manager so the
    device can be provisioned without recompiling.
    - wifi_start(): try STA with the saved credentials from /config.json; on failure
    start an access point (SSID "Nixie-<mac>", password "Nixie1234") and launch a
    web-based WiFi manager.
    - WiFi manager (built-in ESP32 WebServer, not AsyncWebServer): scans for nearby
    networks and presents them in a dropdown, so the user selects an SSID and only
    enters the password. On submit it stores the credentials in /config.json, sets
    STA mode, and reboots.
    - Fix AP passphrase: "Nixie1!" was 7 ch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
2026-10-13 refactor(debug): centralize USB debug output behind USB/USBLN/USBPR macros
    Replace the scattered `if(usb) Serial...` guards and the unguarded Serial
    prints with a single set of debug macros gated on the `usb` strap flag.
    - defines.h: add USB(...) (printf), USBLN(...) (println) and USBPR(...)
    (print) macros, all guarded by `if (usb)`.
    - main.cpp: convert all `if(usb) Serial...` boot/RTC/NTP/WiFi/OTA debug
    output to the new macros. `if(usb) Serial.begin(115200);` is kept as-is
    (Serial init, not a print).
    - menu.cpp: convert time/date, brightness and offset save messages to USB().
    - myrtc.cpp: convert guarded prints to the macros and guard the previously
    unconditional Serial.print/prin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
2026-10-13 refactor(style): use constexpr constants and encapsulate display state
    Style 2: replace #define numeric constants with typed constexpr in
    src/defines.h (pins, I2C addresses, temp offsets, SPIFFS flag) and
    src/menu.h (brightness/offset bounds). I2C addresses are constexpr int
    to match the Wire API and avoid overload ambiguity. Function-like
    USB/USBLN/USBPR debug macros kept as macros.
    Style 5: move pwm and dis_mode globals into the Clock class as public
    members (nixie.pwm, nixie.dis_mode). Remove extern declarations in
    classes.h/main.h and global definitions in main.cpp; update all
    references in main.cpp, menu.cpp, config.cpp, classes.cpp. nix_time and
    bootstrap flags intentionally remain gl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
2026-10-14 change filament cycling frequency for better cathode poisoning prevention
