Synthron/Nixie/(notices)

Notices in the files:
Hardware/PCB/3d/USB-B-S-F-B-TH.stp:
author */ ('License CC BY-ND 4.0'),
